Yixuan2068296/Remote-Lab_Buck-Converter/Buck Lab - Complete Material/Replace Components/SER0046 - 270 degree Rotation Micro Servo.jpg

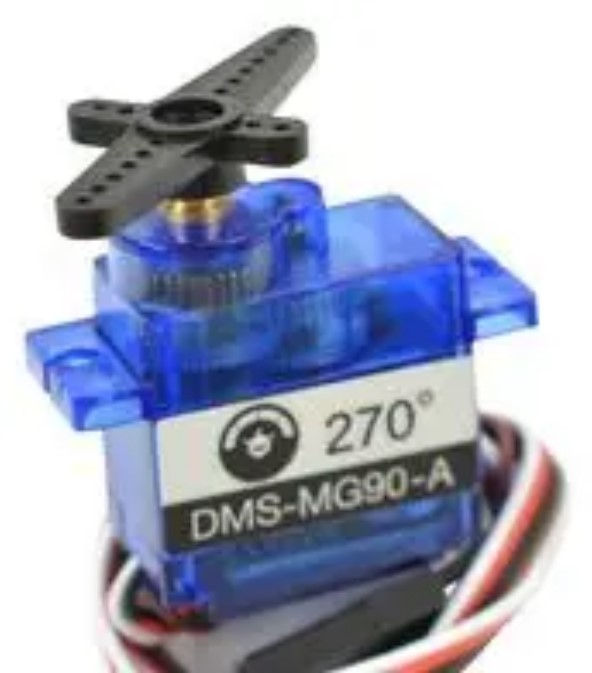
Buck Lab - Complete Material/Replace Components/SER0046 - 270 degree Rotation Micro Servo.jpg
