Yixuan2068296/Remote-Lab_Buck-Converter/README.md

# Remote-Lab_Buck-Converter
This is a logbook for my MSc project
