Yixuan2068296/Remote-Lab_Buck-Converter/Buck Lab - Complete Material/Replace Components/Components.xlsx

MCP4151-502E/P | 4 | Volatile Digital Potentiometer, 5 kohm, Single, SPI, Linear, ± 20%, 1.8 V | https://uk.farnell.com/microchip/mcp4151-502e-p/ic-dgtl-pot-sngl-5k-spi-8dip/dp/1840832?mckv=_dc|pcrid|565482043082|plid||kword||match||slid||product|1840832|pgrid|129965253803|ptaid|pla-1707592839797|&CMP=KNC-GUK-GEN-SHOPPING-SMART-AUTOMATION-HIGHROAS-Test860&gross_price=true
MCP4151-503E/P | 4 | Volatile Digital Potentiometer, 50 kohm, Single, Serial, SPI, Linear, ± 20%, 1.8 V | https://uk.farnell.com/microchip/mcp4151-503e-p/ic-dgtl-pot-sngl-50k-spi-8dip/dp/1840819?st=mcp415
NX3L4357GM,115 | 2 | Analogue Switch ICs ANLG SWT SP3T 3.3V | https://www.mouser.co.uk/ProductDetail/NXP-Semiconductors/NX3L4357GM115?qs=5C9Q4QJFsuNdi101Rt%2FxvQ%3D%3D
SER0046, | 2 | 270 degree Rotation Micro Servo | https://uk.farnell.com/dfrobot/ser0046/servo-motor-270deg-1-47n-m-6v/dp/3769942?mckv=_dc|pcrid||plid||kword||match||slid||product|3769942|pgrid||ptaid|&CMP=KNC-GUK-GEN-SHOPPING-PMAX-Low_ROAS-Test915&gross_price=true
sourcing map 50W 100R Ohm | 2 | Wirewound Ceramic Potentiometer Variable Rheostat Resistor with Knob | https://www.amazon.co.uk/dp/B07JLQXN8Z?s=industrial
