Yixuan2068296/Remote-Lab_Buck-Converter/Buck Lab - Complete Material/Replace Components/sourcing map 50W 100R Ohm.jpg

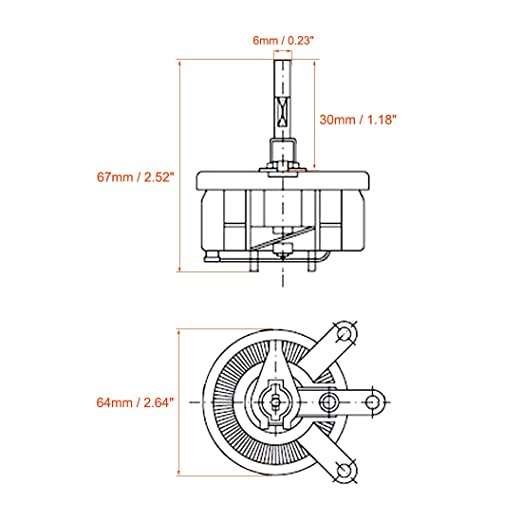
Buck Lab - Complete Material/Replace Components/sourcing map 50W 100R Ohm.jpg
