Yixuan2068296/Remote-Lab_Buck-Converter/Buck Lab - Complete Material/Logbook/Logbook_2022-06-24&25.pdf

Components Choice:
Arduino nano33 iot control:
4 Trimmer Resistors -> Digital Potentiometers
3 Switches -> Digital Switches

RV1 & RV2 (2.22KΩ) RV3 & RV4 (50KΩ)
- MCP413X（options: 5KΩ, 10KΩ, 50KΩ, 100KΩ）
- MAX5394 / MAX5395（options: 10KΩ, 50KΩ, 100KΩ） LC_MODE Switch
- NX3L4357 single pole triple throw.
SyncBuck Switch
- SN74LVC1G3157 single pole double throw. CapSelect Switch
– FDS8858CZ Dual N&P channel powertrench MOSFET Remain Problem: voltage drop at switch - MOSFET: Vds

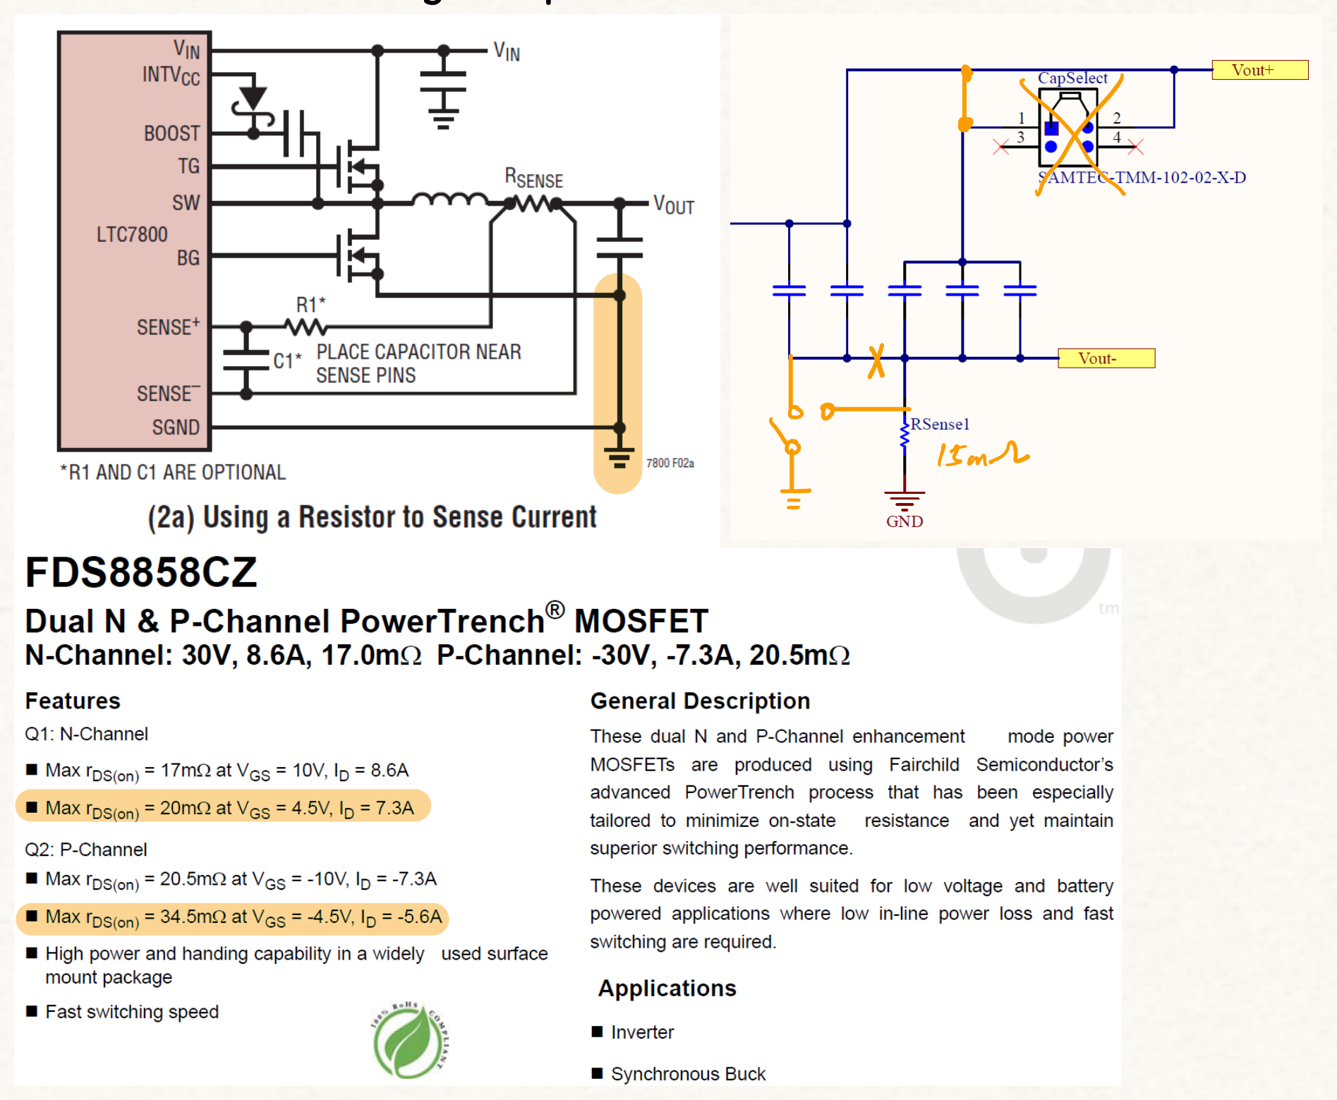
[picture p38: figure]

This voltage drop can be placed at Vout- and GND, which can replace original Rsense1 (0.015 Ohm).

Controllable Load Resistance
Approach 1: Digital potentiometer as load resistance.

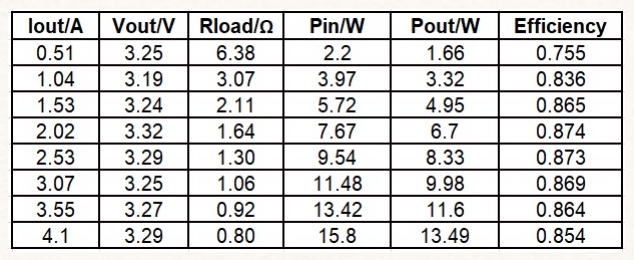
[picture p39: figure]

Resistance Requirement:
From Buck converter lab course, the load current should ramp up to 4A (5A is a max for load current). The graph shows load resistor variant range for 0-4A load current. As digital potentiometer minimum resistance is limited by wiper resistance
- around 60 Ohm, a few ohm resistance can not be achieved by digital potentiometer.
Power Handling Capability:
The load resistance consume high power 13.5W for 4A&3.3V output. Max output power is up to 30W. Digital potentiometer only has mW power rating. (Smallest digital potentiometer X9C102 - 1K Ohm)
Conclusion: Digital potentiometer cannot be used as a dummy load for this buck converter.

Approach 2: Rheostat as load resistance with a servo motor.
It is easy to find a high power low resistance shaft potentiometer (50W & 30 Ohm wire wound ceramic potentiometer). It is also easy to find a rotation servo motor (6V analog continuous rotation servo motor)
Arduino has a very traitor forward function to write to servo (rotate 0-360 degree)
Conclusion: This is the simplest and safest way to build a remote control resistance variable dummy load.

Approach 3: Switching a bank of fixed resistors.
Resistance Requirement & Power handling capability:
Power film resistor: MP9100 TO-247 Kool-Pak has following resistance values & 100W continuous power rating at 25 degree case temp with heat sink

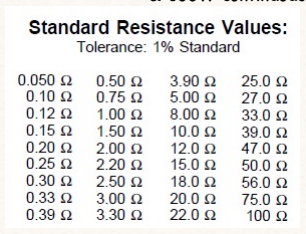
[picture p40: figure]

Switch design:
This lab course requires high resolution at small values, which makes the circuit for connecting fixed resistors complicated. The load resistance range is hard to make continuous and log scale.
The switch still has the problem of voltage drop, which will impact output current and voltage of the load.
Conclusion: A bank of fixed power resistor requires complex switch circuit design.

SyncBuck Switch
- SN74LVC1G3157 single pole double throw X
This switch has positive and negative voltage & current.
Need the same design as CapSelect switch
CapSelect Switch
– FDS8858CZ Dual N&P channel powertrench MOSFET X
This N&P channel MOSFET can support bidirectional current flow, but Arduino pin cannot provide the negative gate voltage of Vgs of P-type MOSFET.

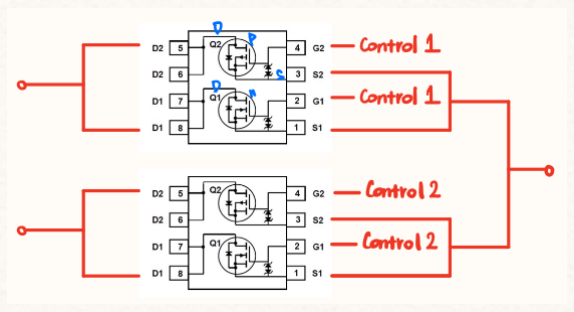
[picture p41: figure]

Dual N-type MOSFET: Drain and Source placed inversely to support bidirectional current flow.

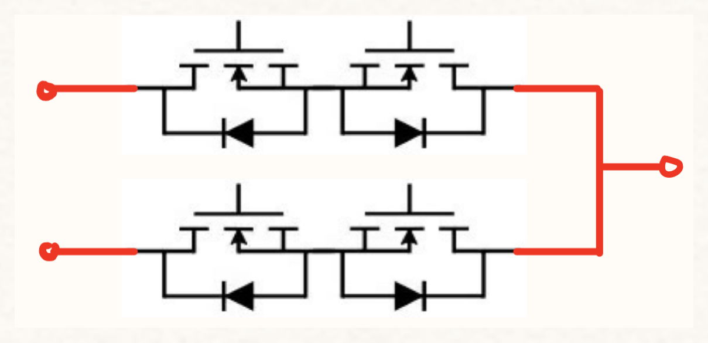
[picture p42: figure]
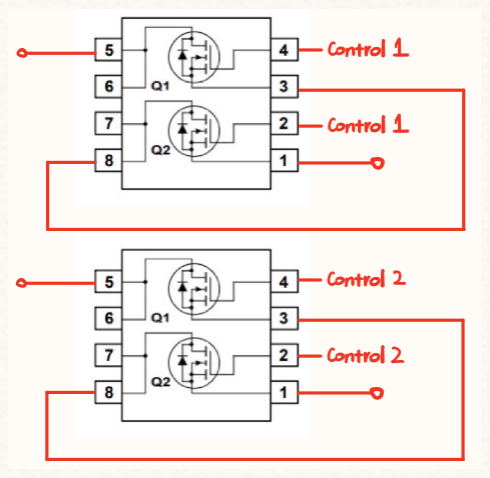
[picture p43: figure]

## LC_MODE Switch - NX3L4357

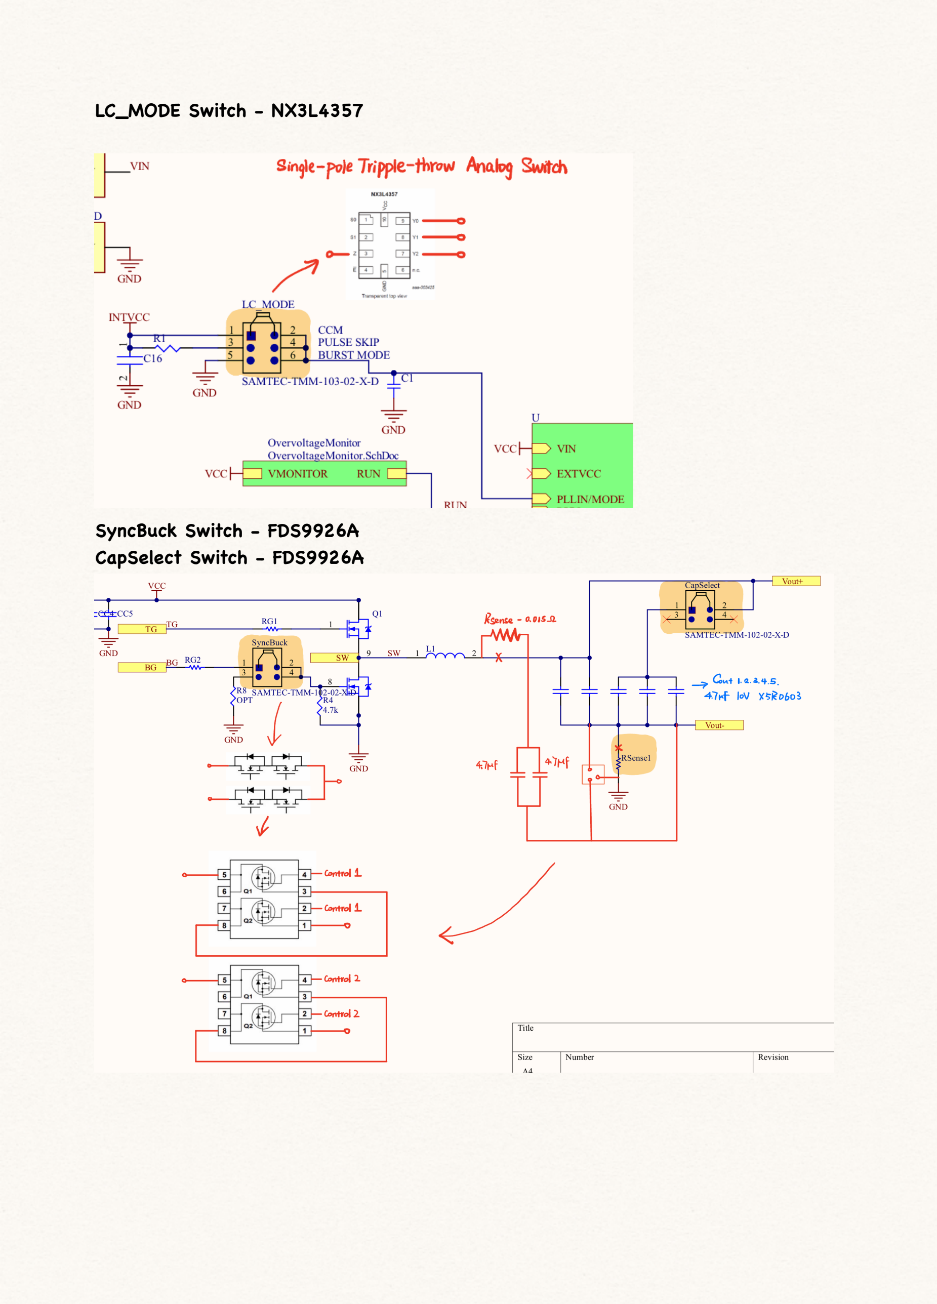
[picture p44: page 3]

## SyncBuck Switch - FDS9926A CapSelect Switch - FDS9926A

## RV1 & RV2 - MCP41X1

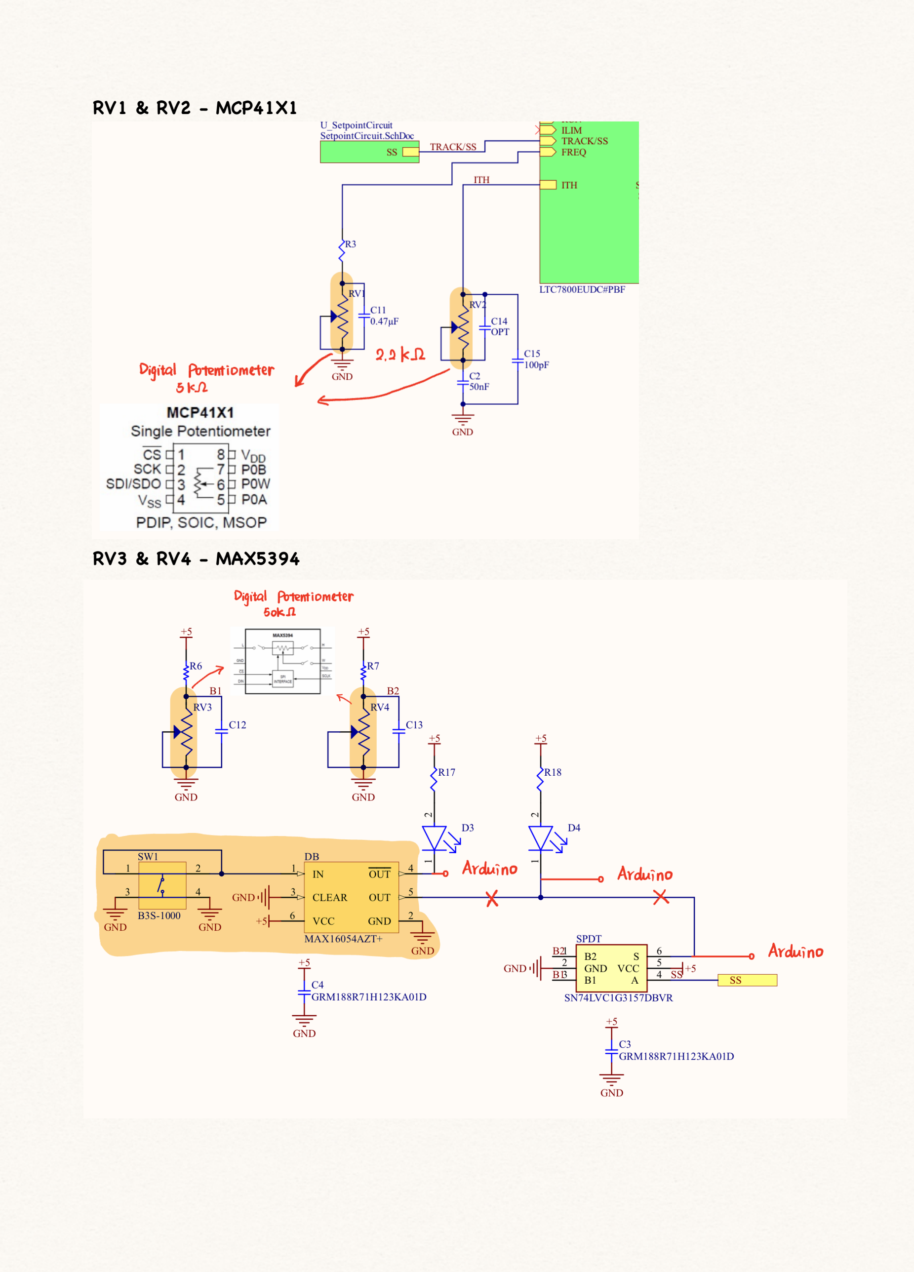
[picture p45: page 4]

## RV3 & RV4 - MAX5394
