Yixuan2068296/Remote-Lab_Buck-Converter/Buck Lab - Complete Material/Logbook/Logbook_2022-06-26.pdf

Controllable Load Resistance:
Pair of Servo motor (4.8V 270 degrees rotation servo) + Rotary potentiometer (50W 100 Ohm) Arduino IDE - PWM signal control motor to rotate and stop at specific angle.
(Careful: the 360 degrees continuous servo will spin and never stop
20ms period 50HZ: 1.5ms stop; 1ms counterclockwise full speed; 2ms clockwise full speed.) 20ms period 50HZ: 1.5ms stop at middle position; 0.5~2.5ms rotate in 270 degrees.

Arduino servo example code:
Use potentiometer to control servo motor angle position.

For this project, the servo motor mounted with a rotary potentiometer, the angle position is received by deserialization of a Jason message. This time, the rotation range is 270 degrees. The datasheet for the 270 degree motor: pulse width range 0.5~2.5ms and 5us resolution; 50Hz 20ms period.
But entire range of servo rotate angle is 180 steps, which will lose rotate resolution.
Better to use myservo.attach(3, 500, 2500); //states the min and max setting are 500us and 2500us mservo.writeMicroseconds(500); //sets the servo position at 0 degree Minimum increment 5us
