Yixuan2068296/Remote-Lab_Buck-Converter/Buck Lab - Complete Material/Logbook/Logbook_2022-08-10.pdf

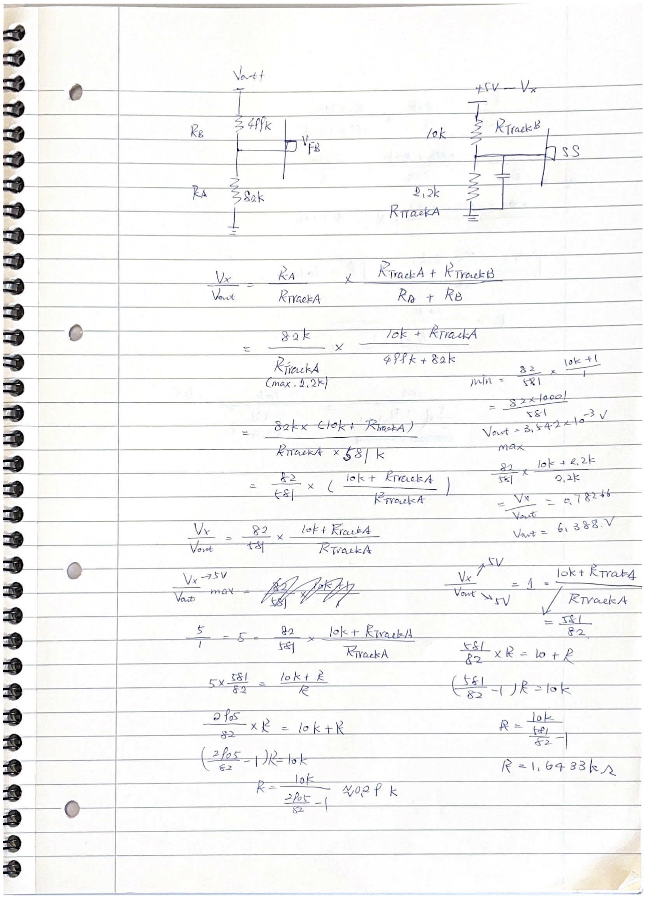
[picture p48: page 1]
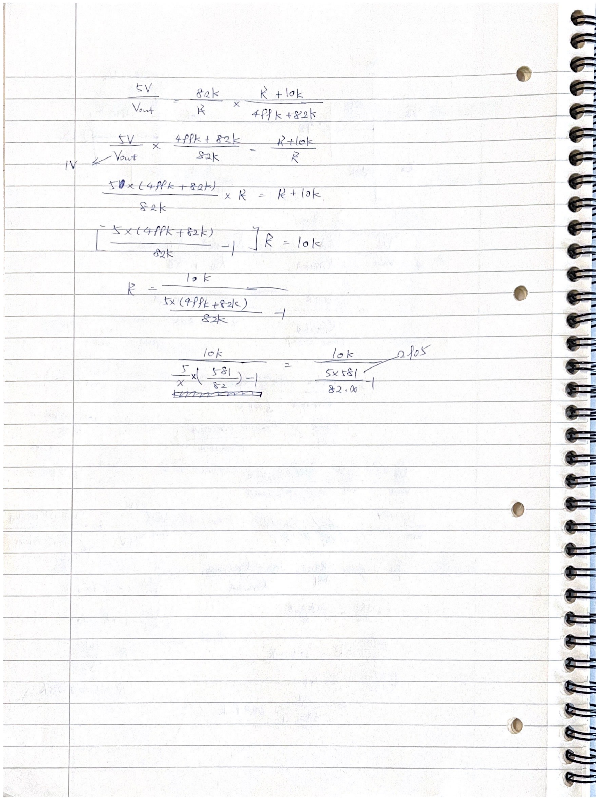
[picture p49: page 2]
