Yixuan2068296/Remote-Lab_Buck-Converter/Buck Lab - Complete Material/Logbook/Logbook_2022-07-21.pdf

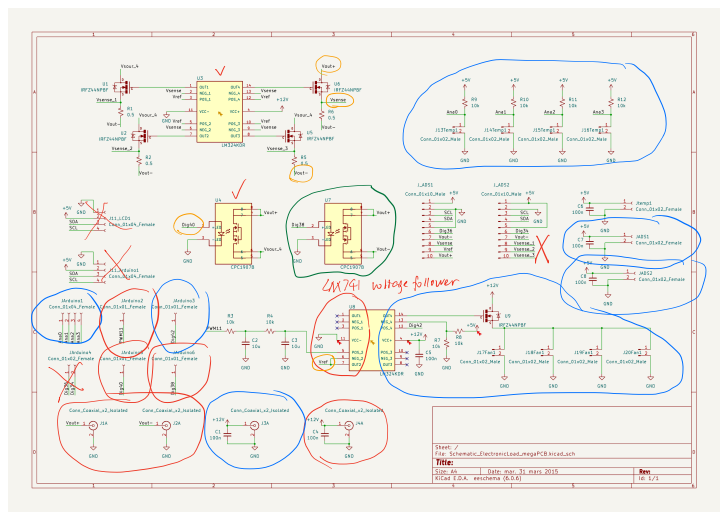
[picture p50: page 1]

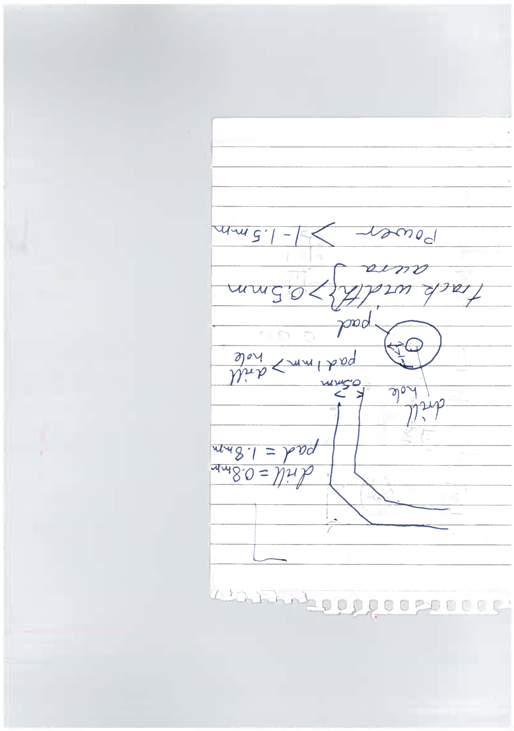
[picture p51: page 2]

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

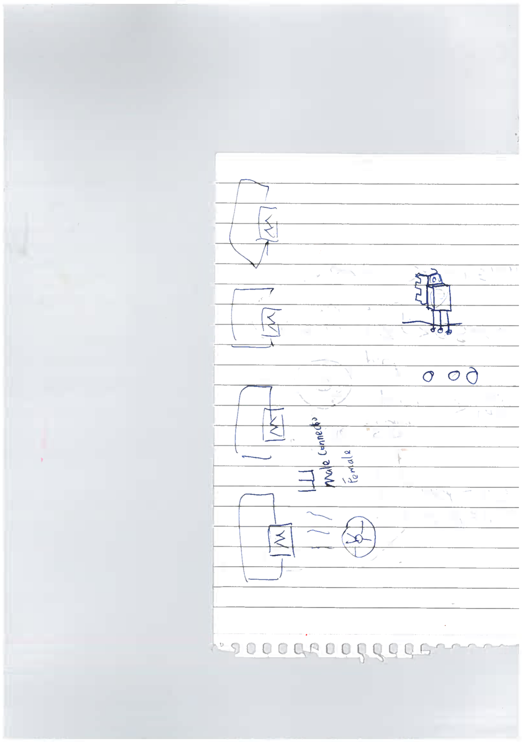
[picture p52: page 3]
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
