Yixuan2068296/Remote-Lab_Buck-Converter/Buck Lab - Complete Material/Logbook/SchematicAndBoardFiles Modification .pdf

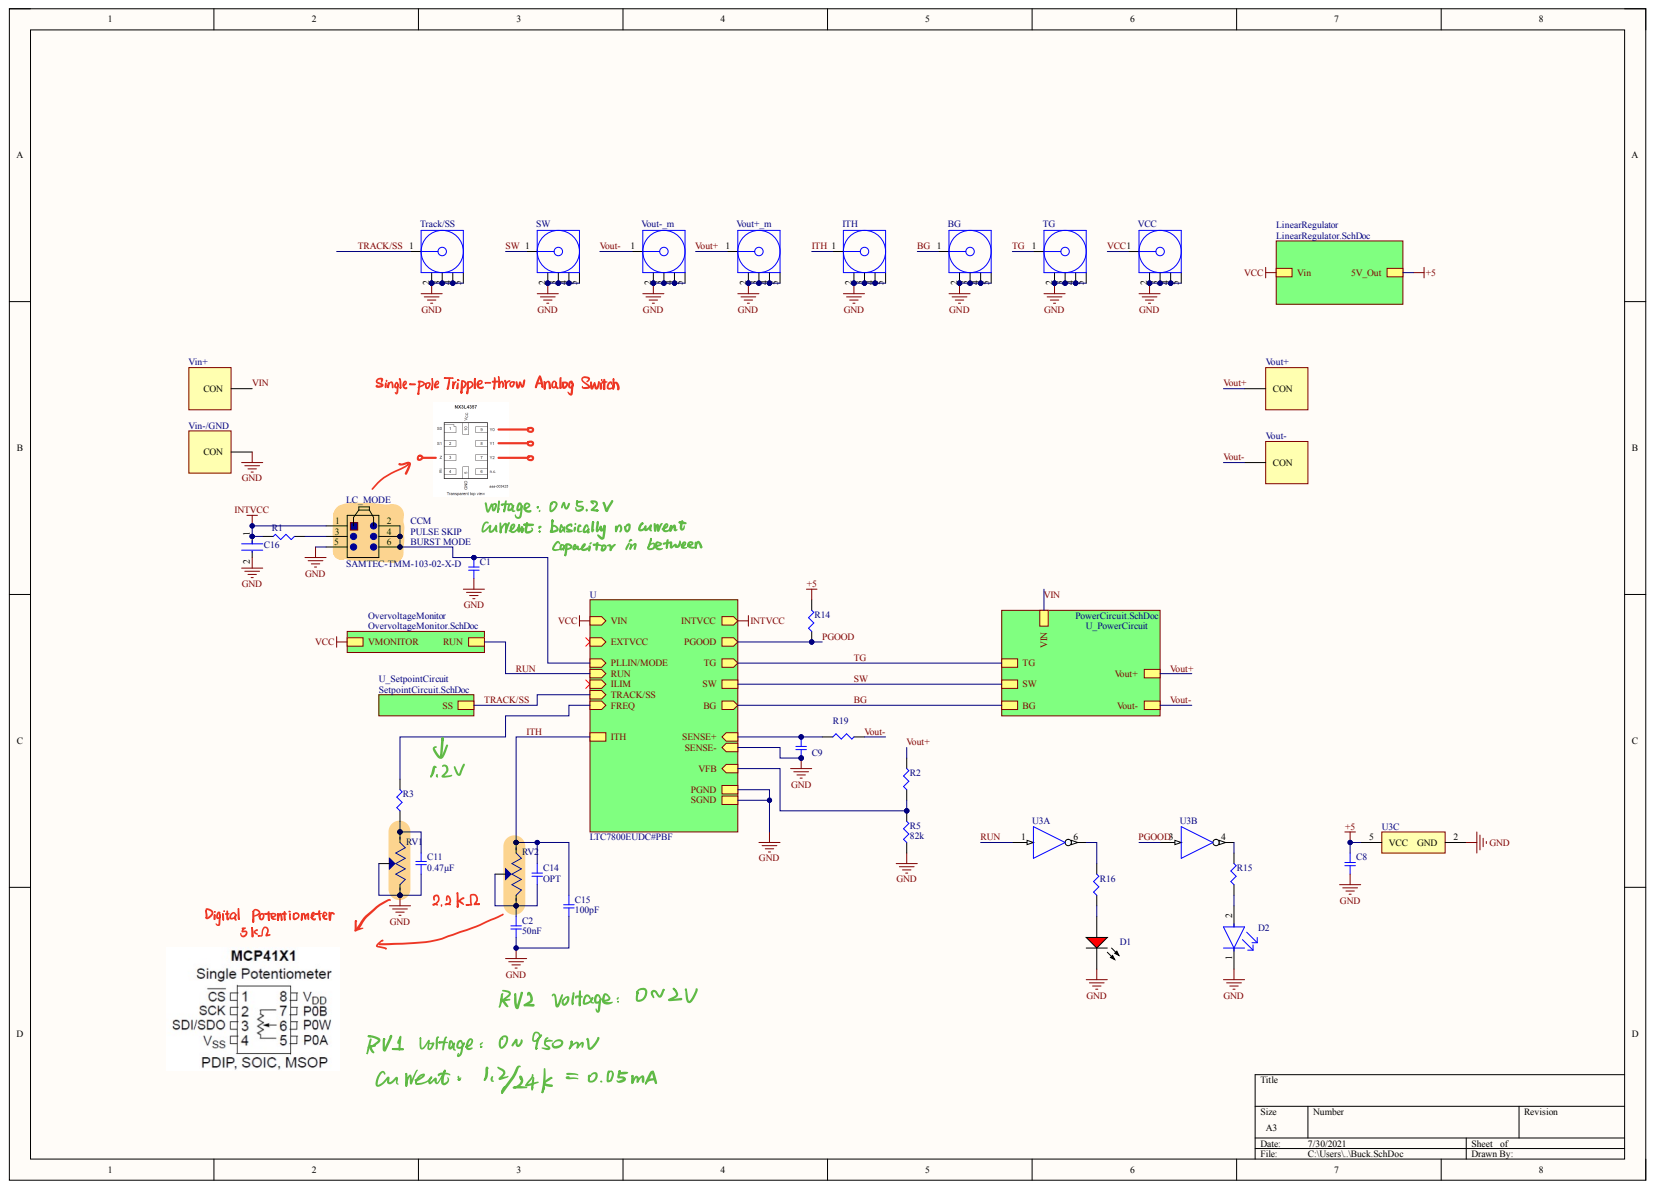
[picture p53: page 1]

witageia5 zvanen.basicagnouwenccapae.no

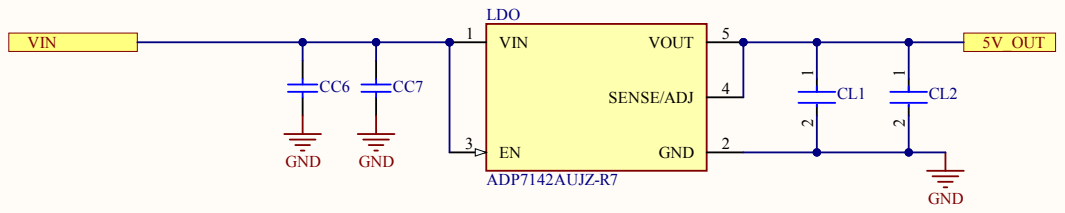
[picture p54: page 2]
Title; Size; Number; Revision; File:; C:\Users\..\LinearRegulator.SchDoc; Drawn By:; VIN; 5V_OUT; GND; VIN 1; VOUT; SENSE/ADJ; LDO; ADP7142AUJZ-R7

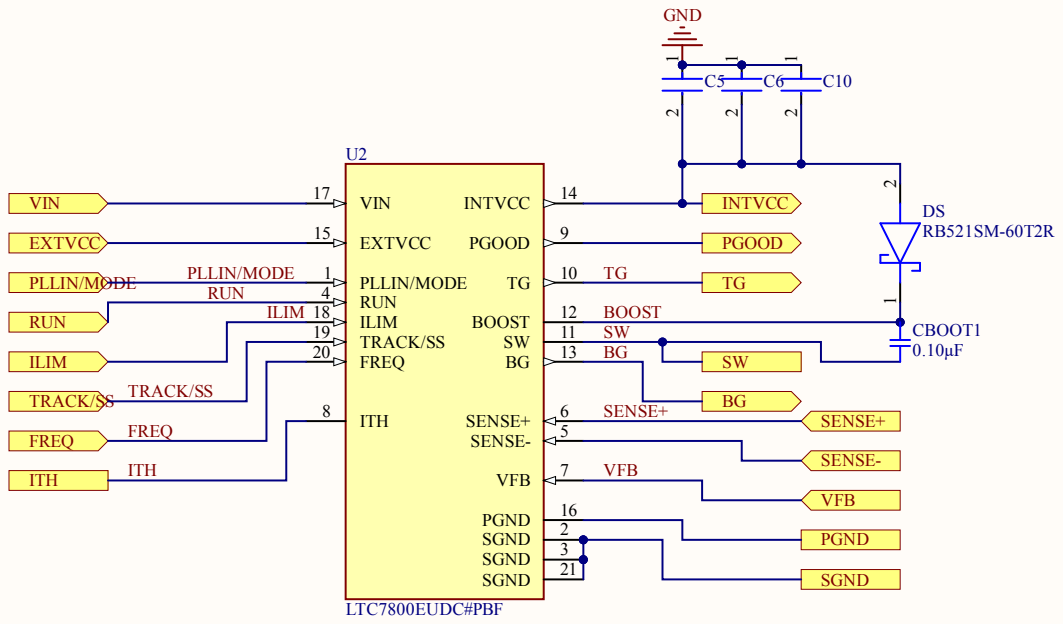
[picture p55: page 3]
Title; Size; Number; Revision; File:; C:\Users\..\LTC7800EUDC#PBF.SchDoc; Drawn By:; VIN; EXTVCC; PLLIN/MODE; RUN; ILIM; TRACK/SS; FREQ; ITH; INTVCC; PGOOD; SENSE+; SENSE-; VFB; PGND; SGND; VIN 17; EXTVCC 15; PLLIN/MODE 1 RUN 4 ILIM 18 TRACK/SS 19 FREQ 20; ITH 8; BOOST; LTC7800EUDC#PBF; GND; BOOST SW; CBOOT1 0.10µF

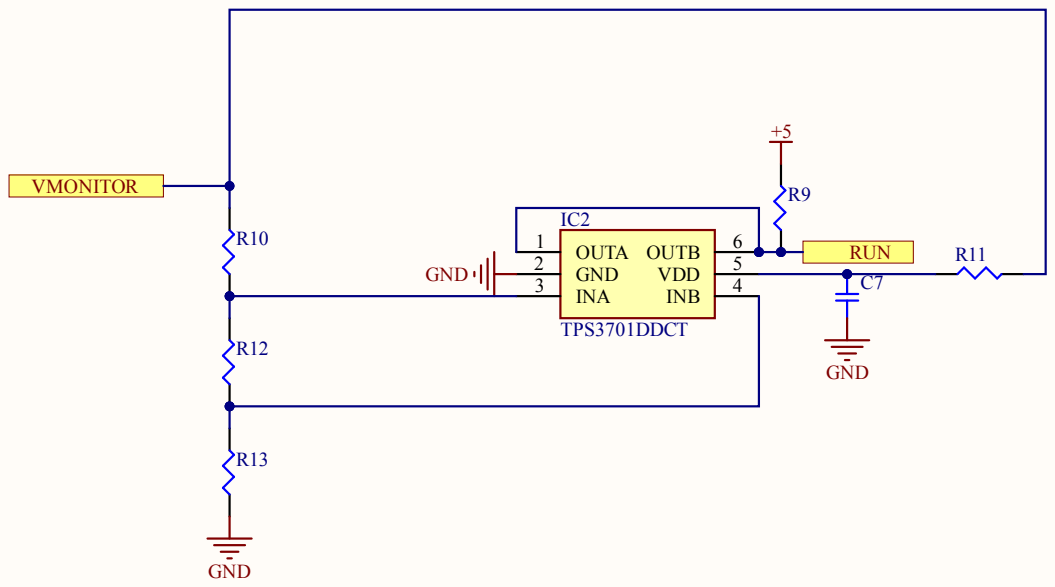
[picture p56: page 4]
Title; Size; Number; Revision; File:; C:\Users\..\OvervoltageMonitor.SchDoc; Drawn By:; OUTA; RUN 1; GND 2 INA 3; OUTB; VDD; INB; TPS3701DDCT; GND; VMONITOR

# Shortcircuit

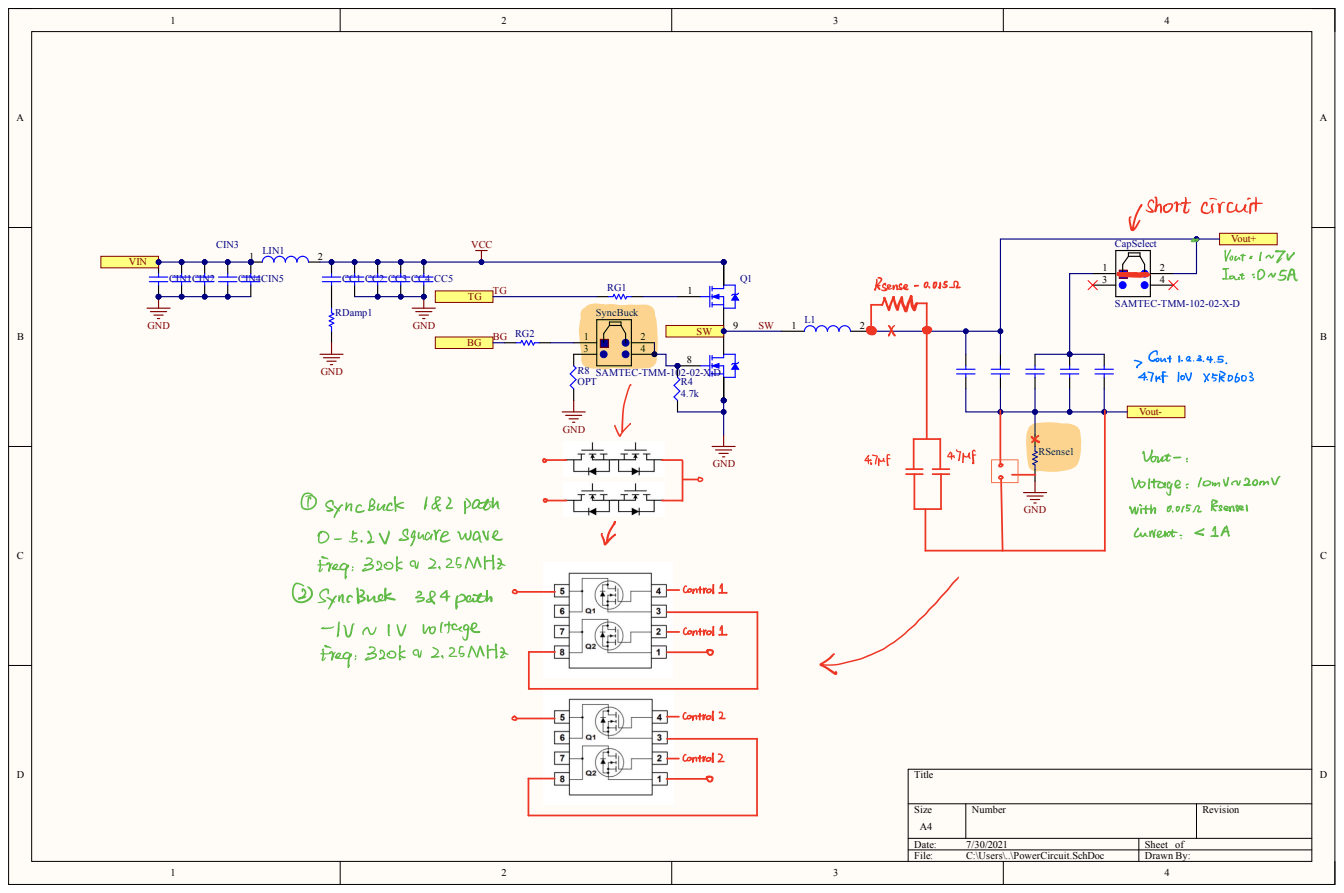
[picture p57: page 5]
Title; Size; Number; Revision; File:; C:\Users\..\PowerCircuit.SchDoc; Drawn By:; GND; 2 LIN1; RDamp1; CIN1CIN2; CIN3; CIN4CIN5; VCC; Vout+; VIN; RSense1; Vout-; SyncBuck; CapSelect; SAMTEC-TMM-102-02-X-D; 篮 䈄 iii ⼼; out23.4.5 4不⼲ 5知3; t.in syncBuck 12path; with anRena; awancut; treqi320ko225MHz; iiid-; control2

R8 SAMTEC-TMM-102-02-X-D OPT

ivuoitag N etreq.su 225MHz

## Digitalpotentiometer

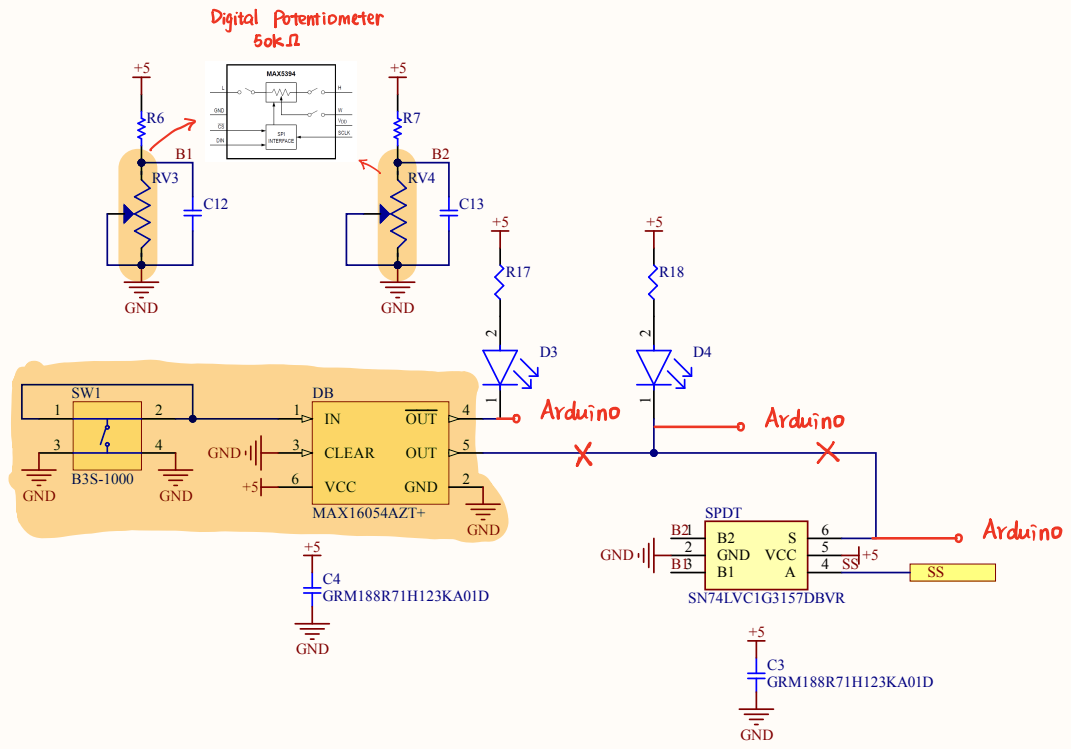
[picture p58: page 6]

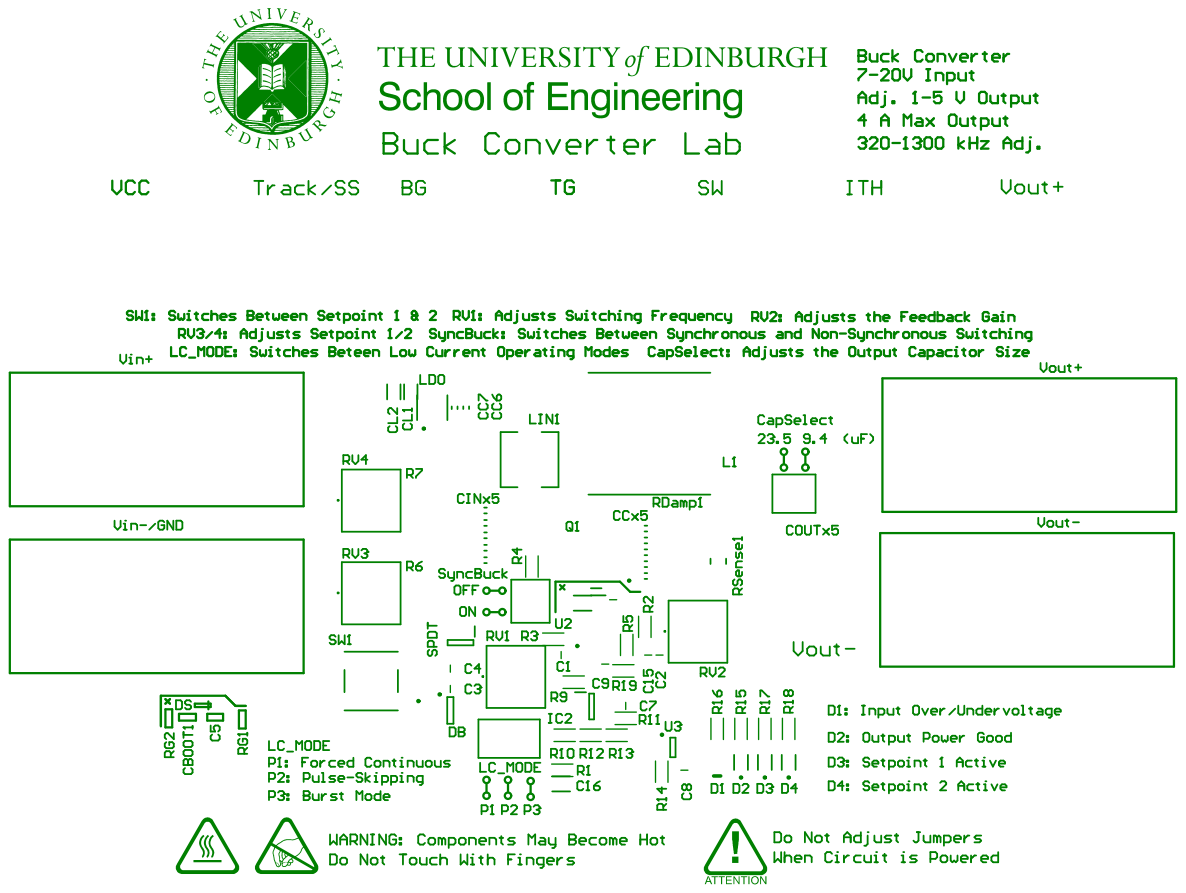
[picture p59: page 7]

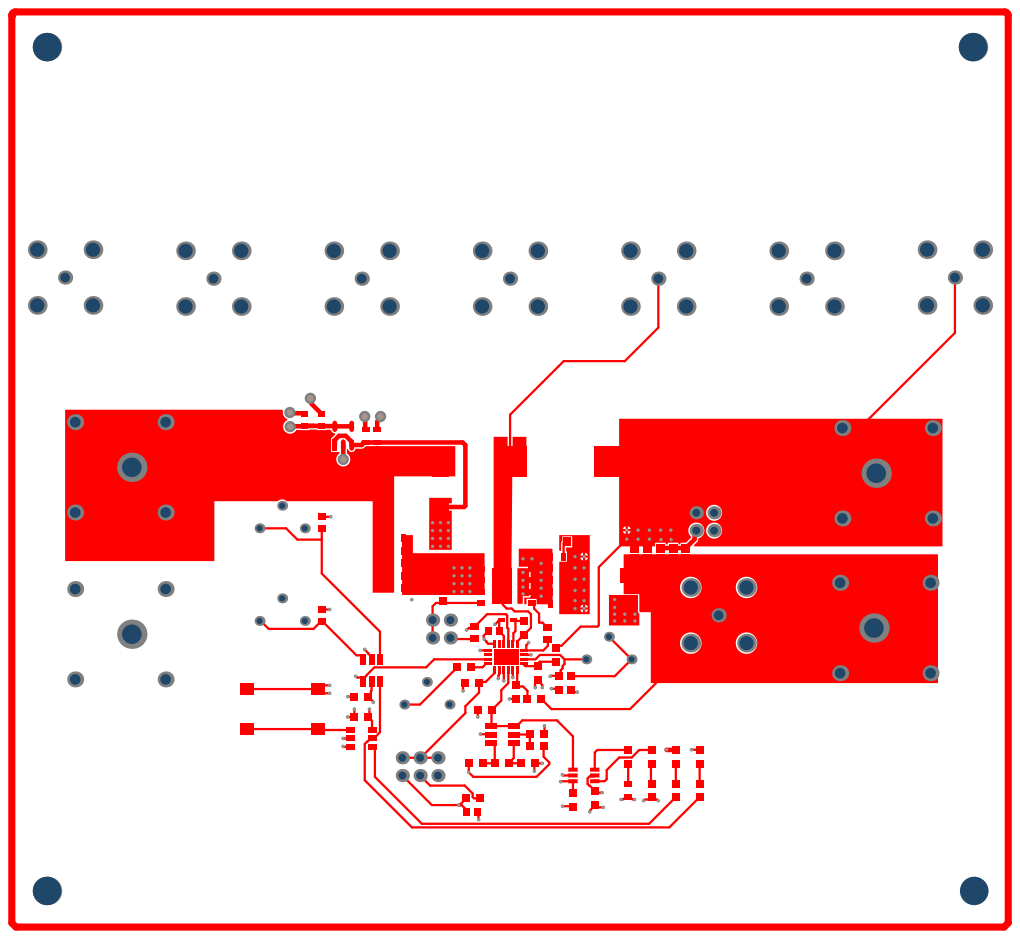
[picture p60: page 8]

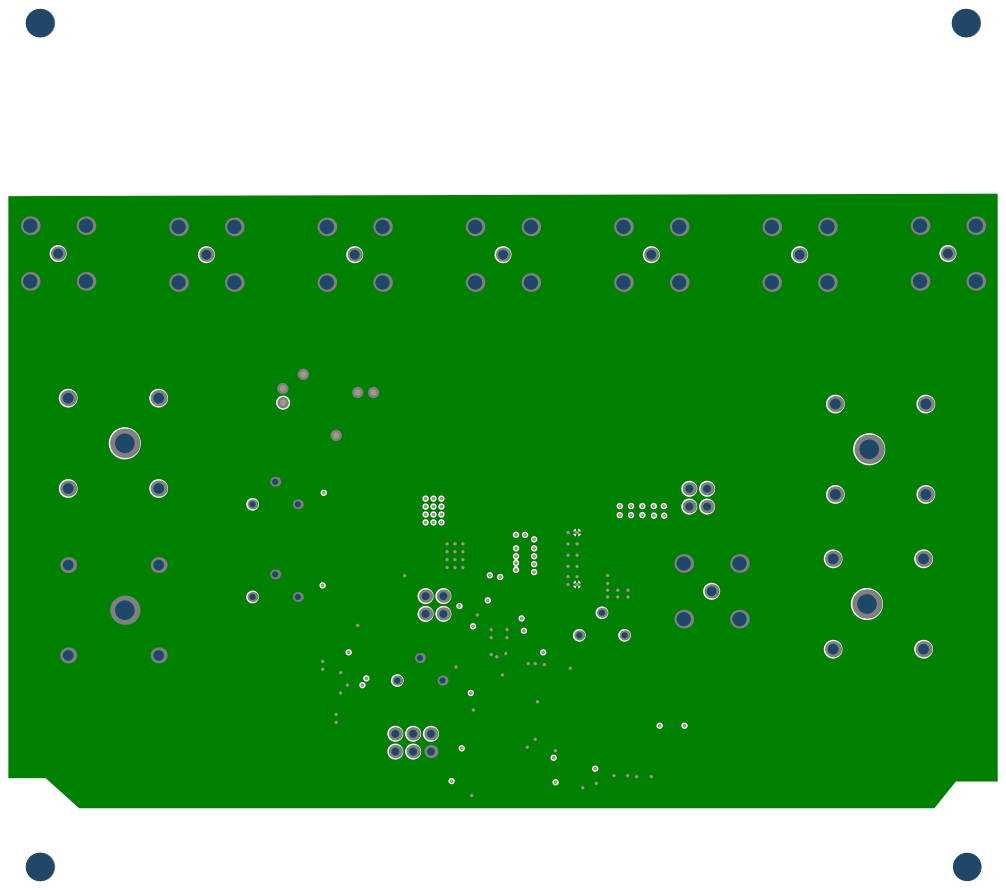
[picture p61: page 9]

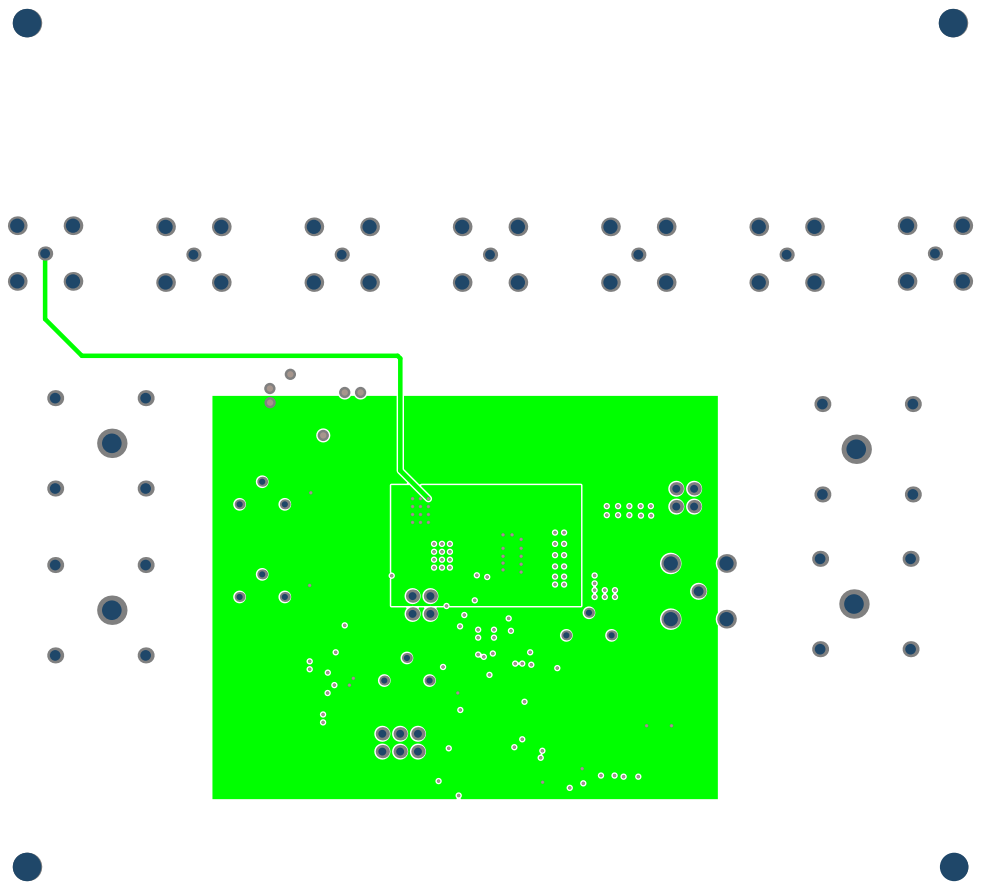
[picture p62: page 10]

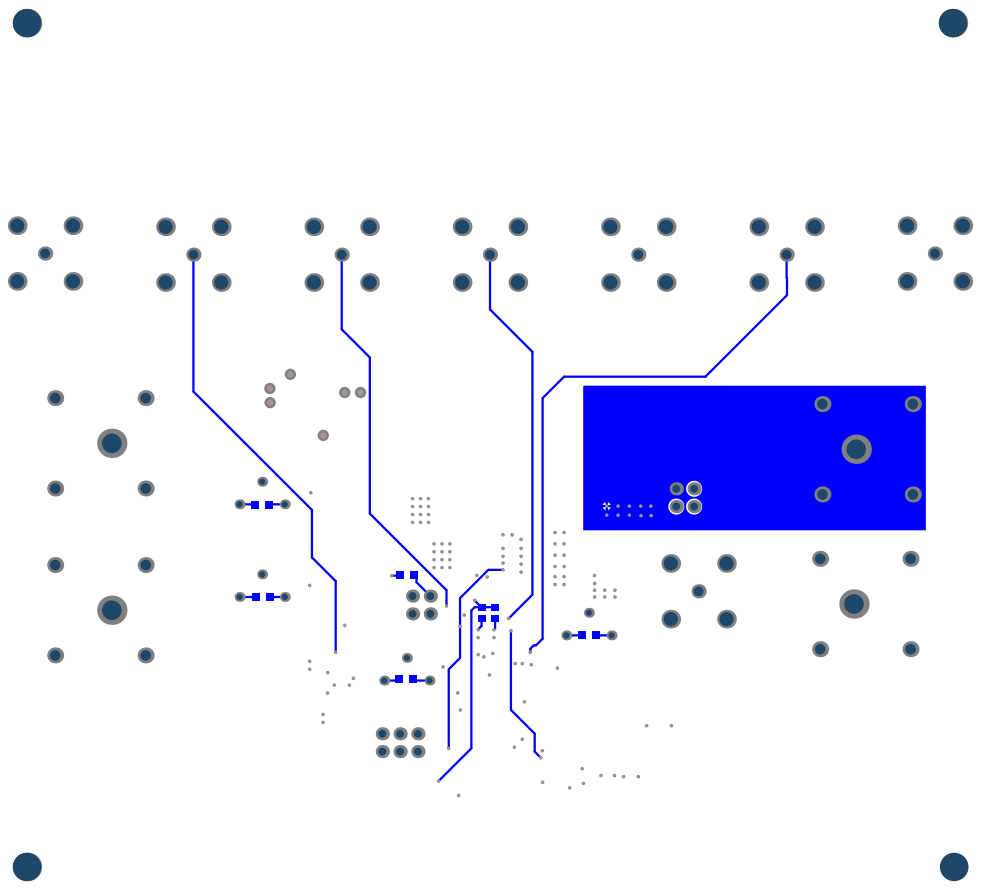
[picture p63: page 11]

# Board Stack Report
