Yixuan2068296/Remote-Lab_Buck-Converter/Buck Lab - Complete Material/PCB Schematic and Design Documents/SchematicAndBoardFiles.pdf

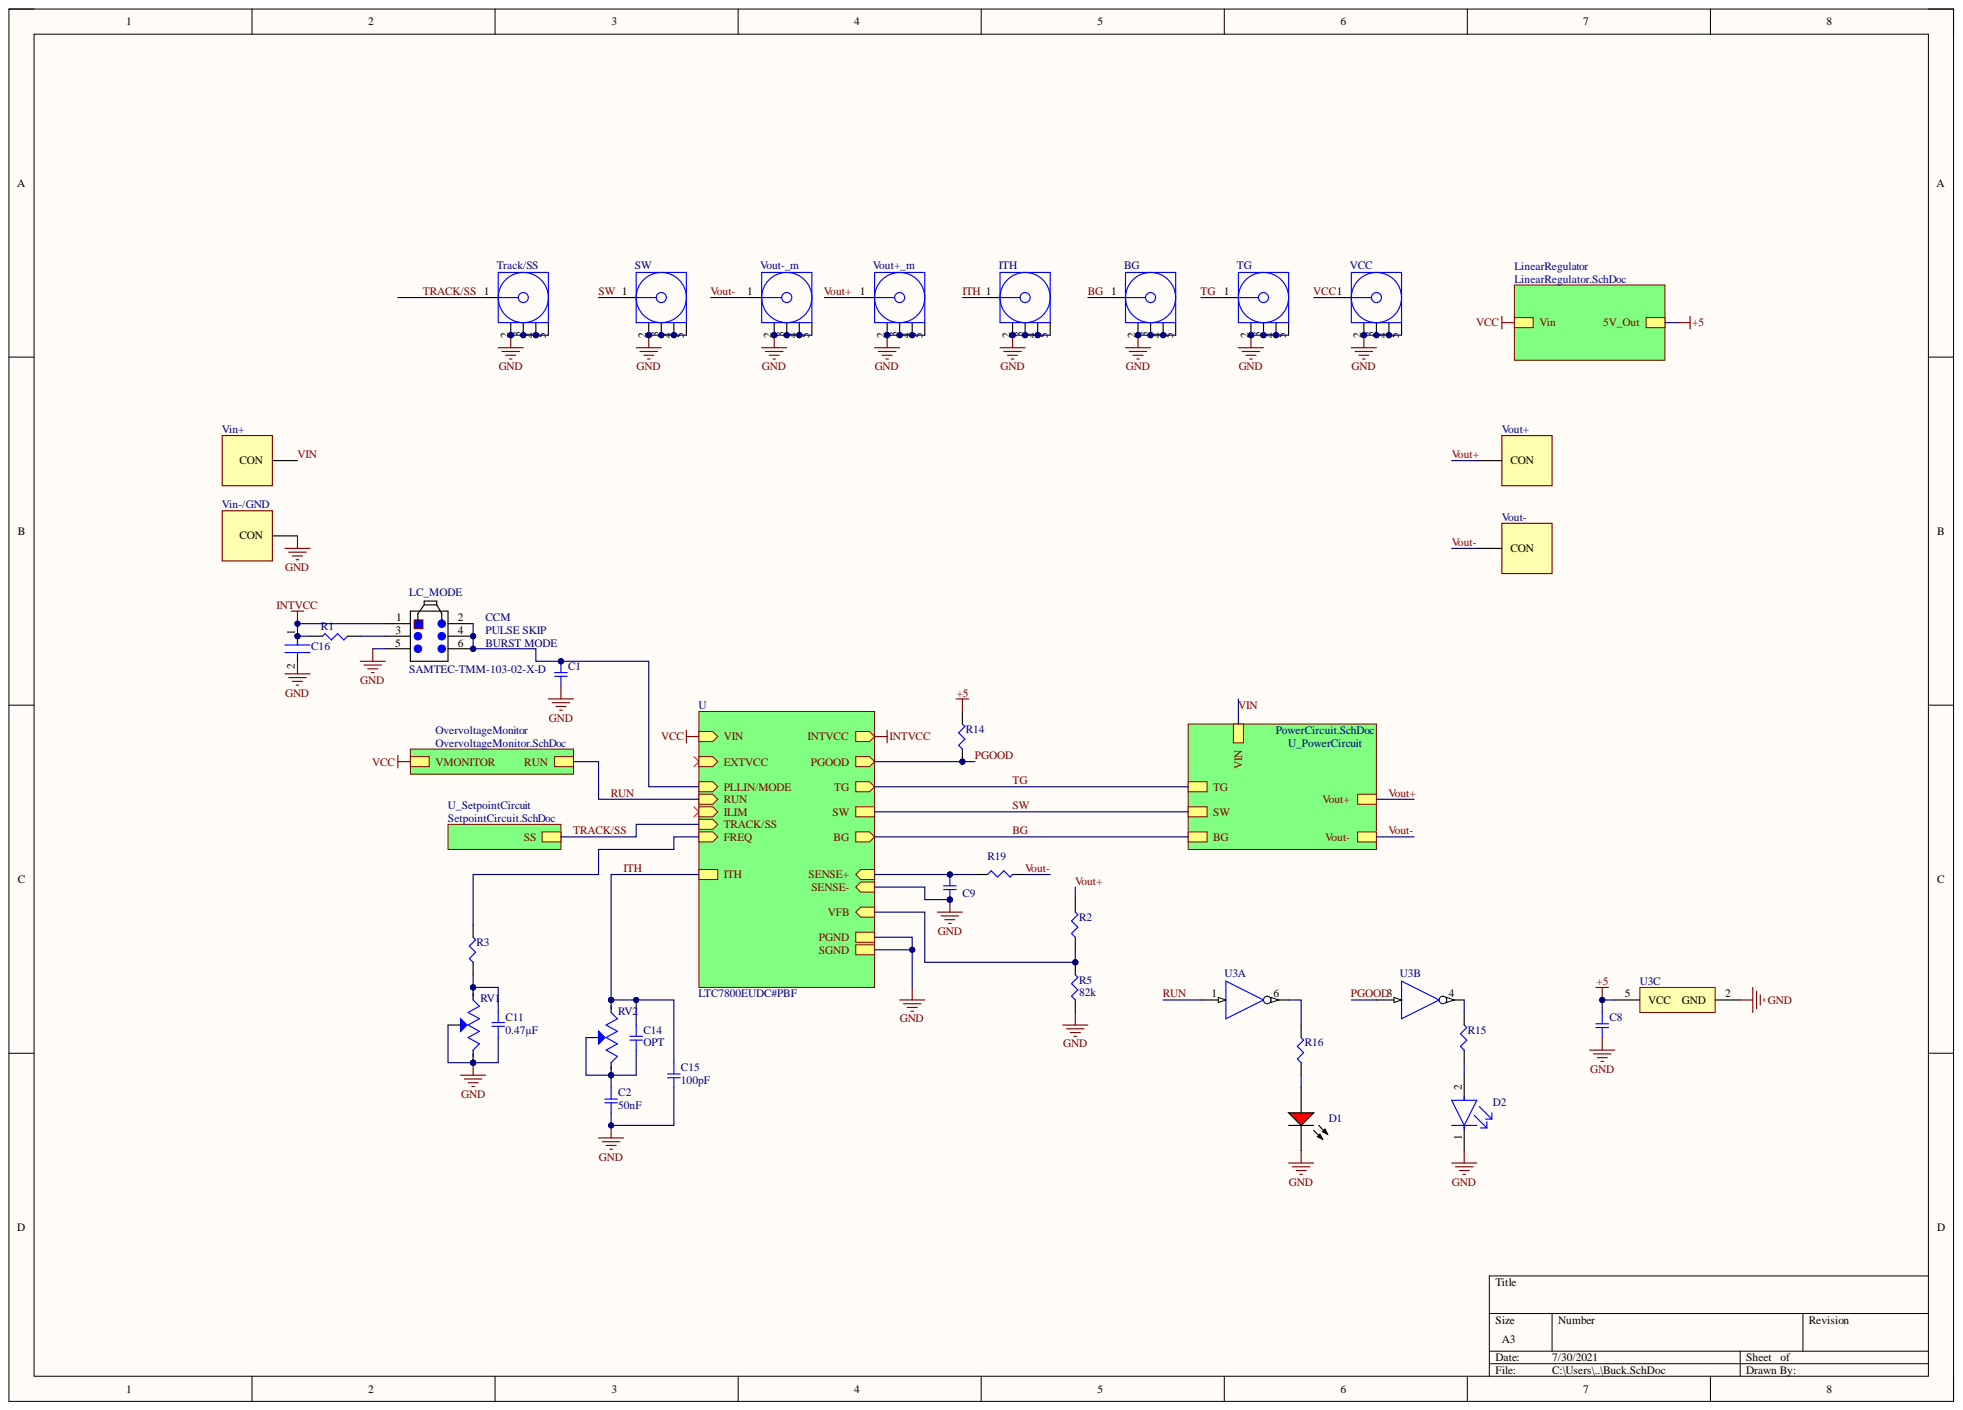
[picture p64: page 1]

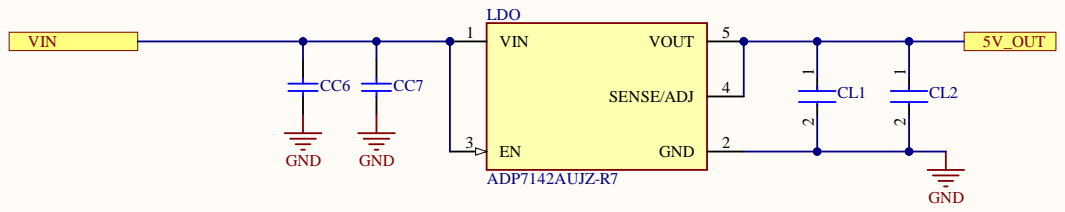
[picture p65: page 2]

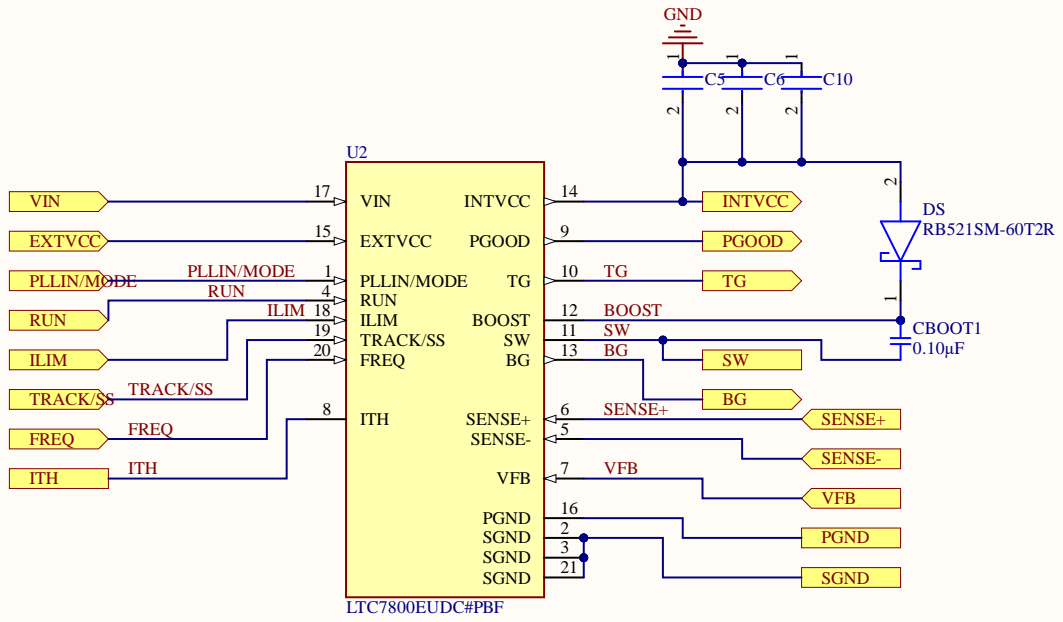
[picture p66: page 3]

FREQ 20 | BG

TRACK/SS | ITH 8

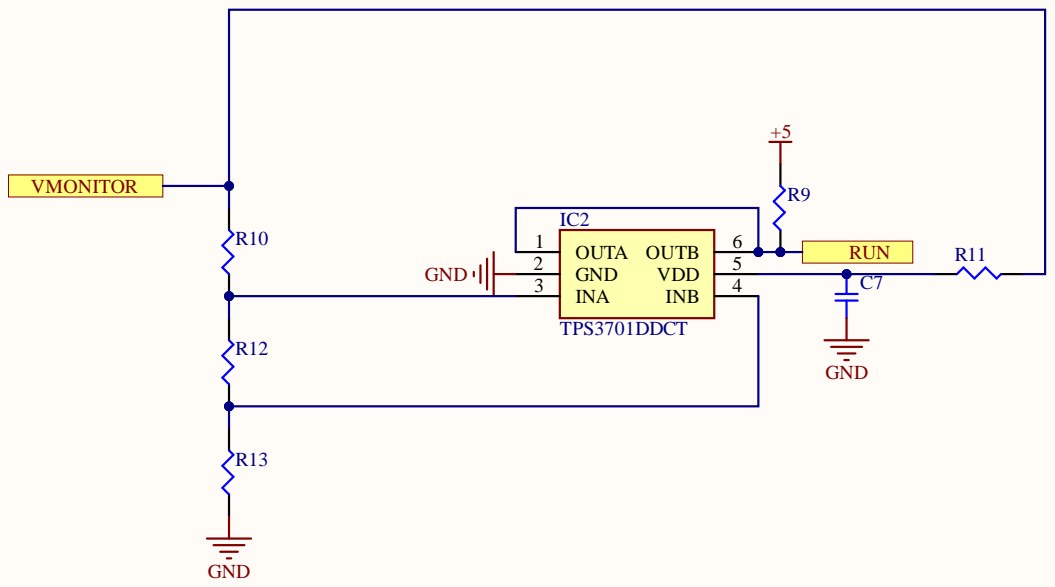
[picture p67: page 4]

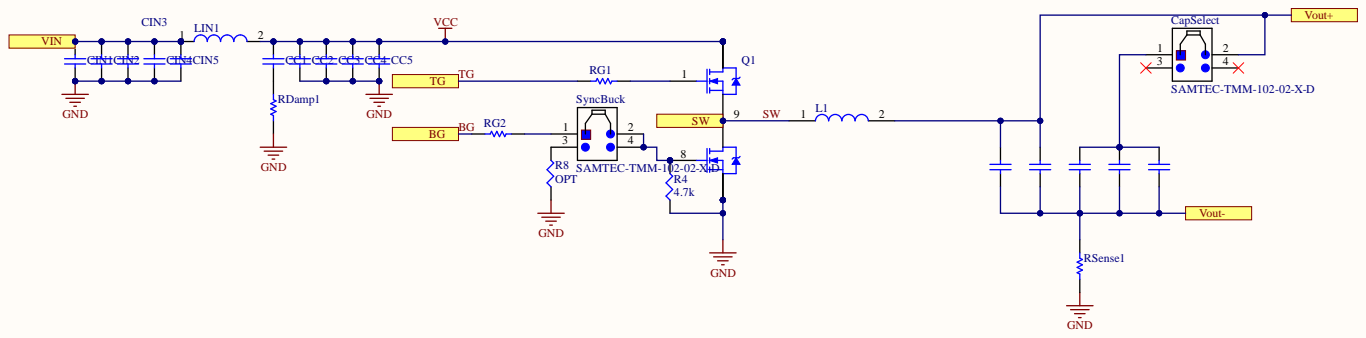
[picture p68: page 5]

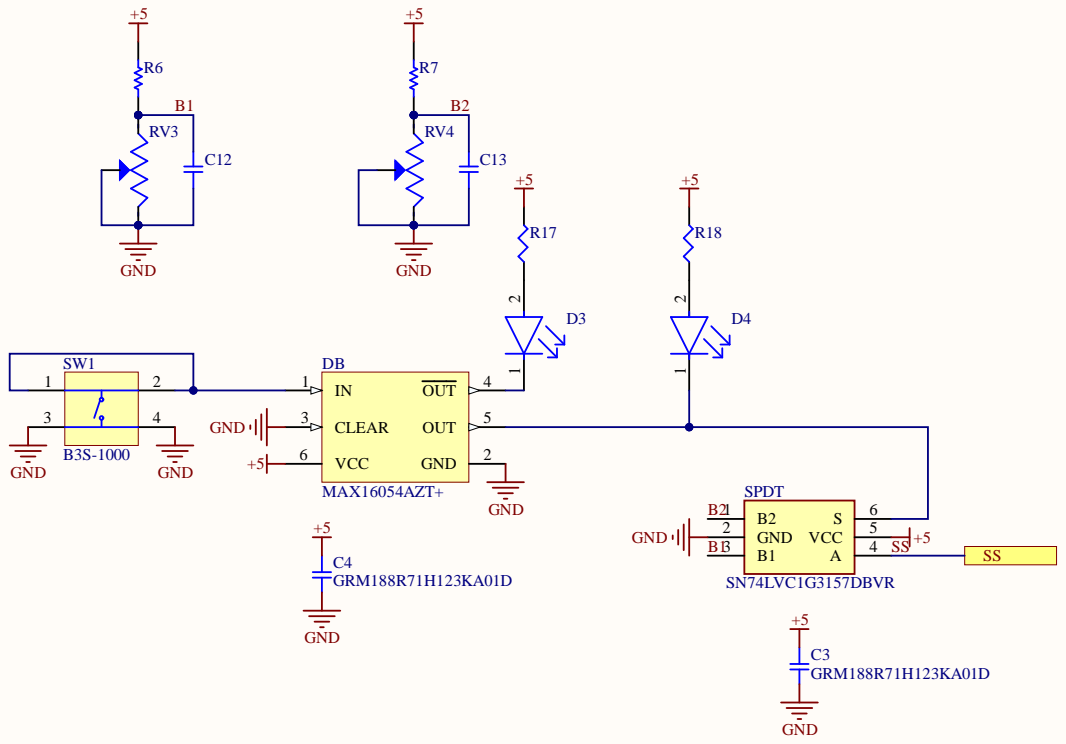
[picture p69: page 6]

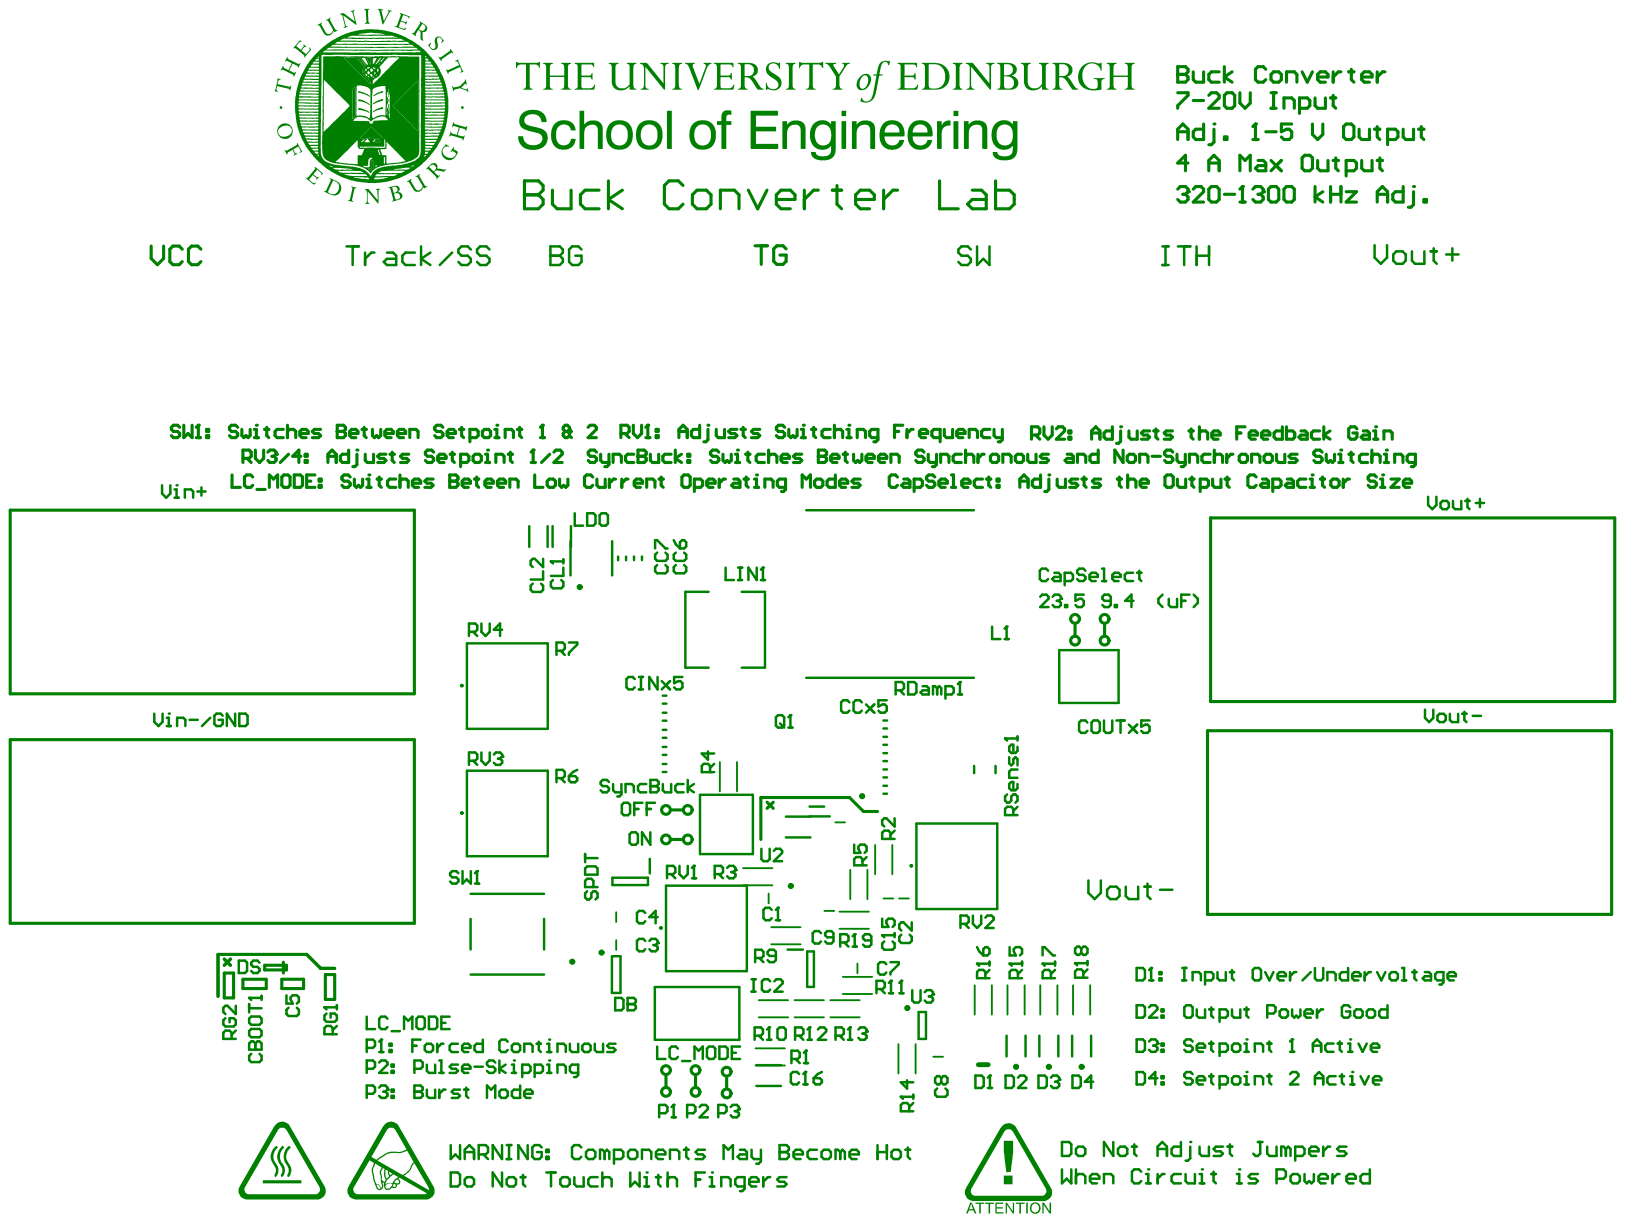
[picture p70: page 7]

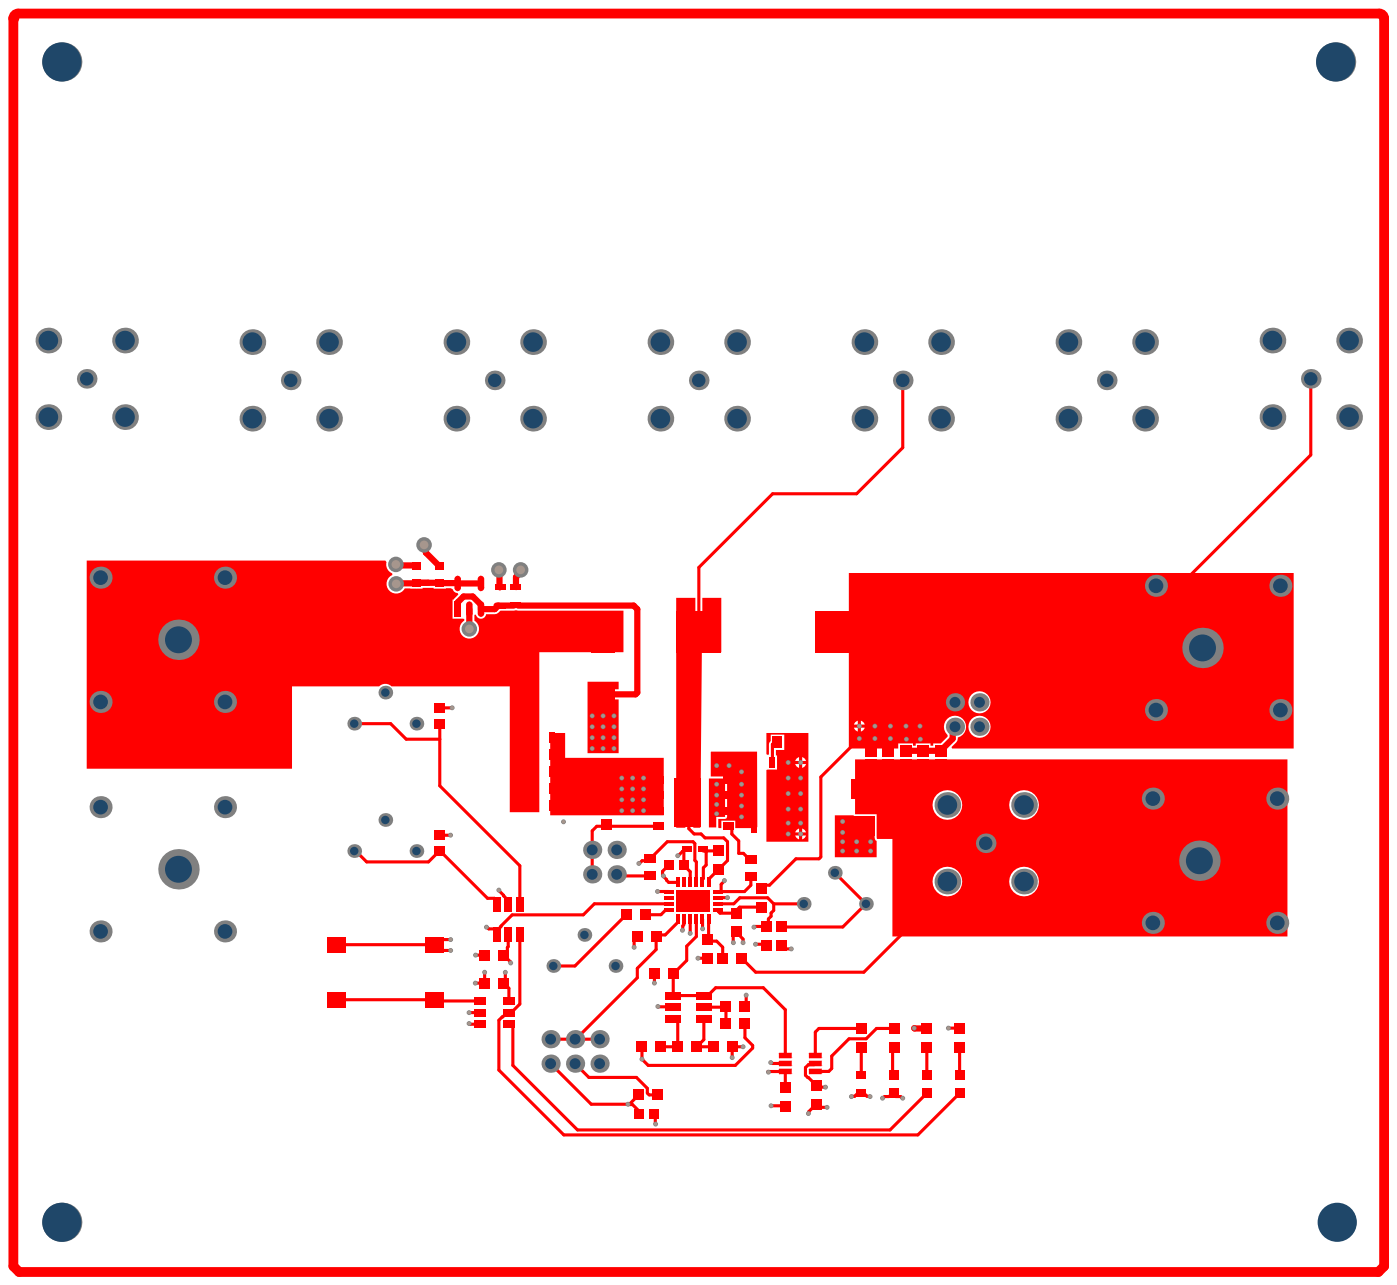
[picture p71: page 8]

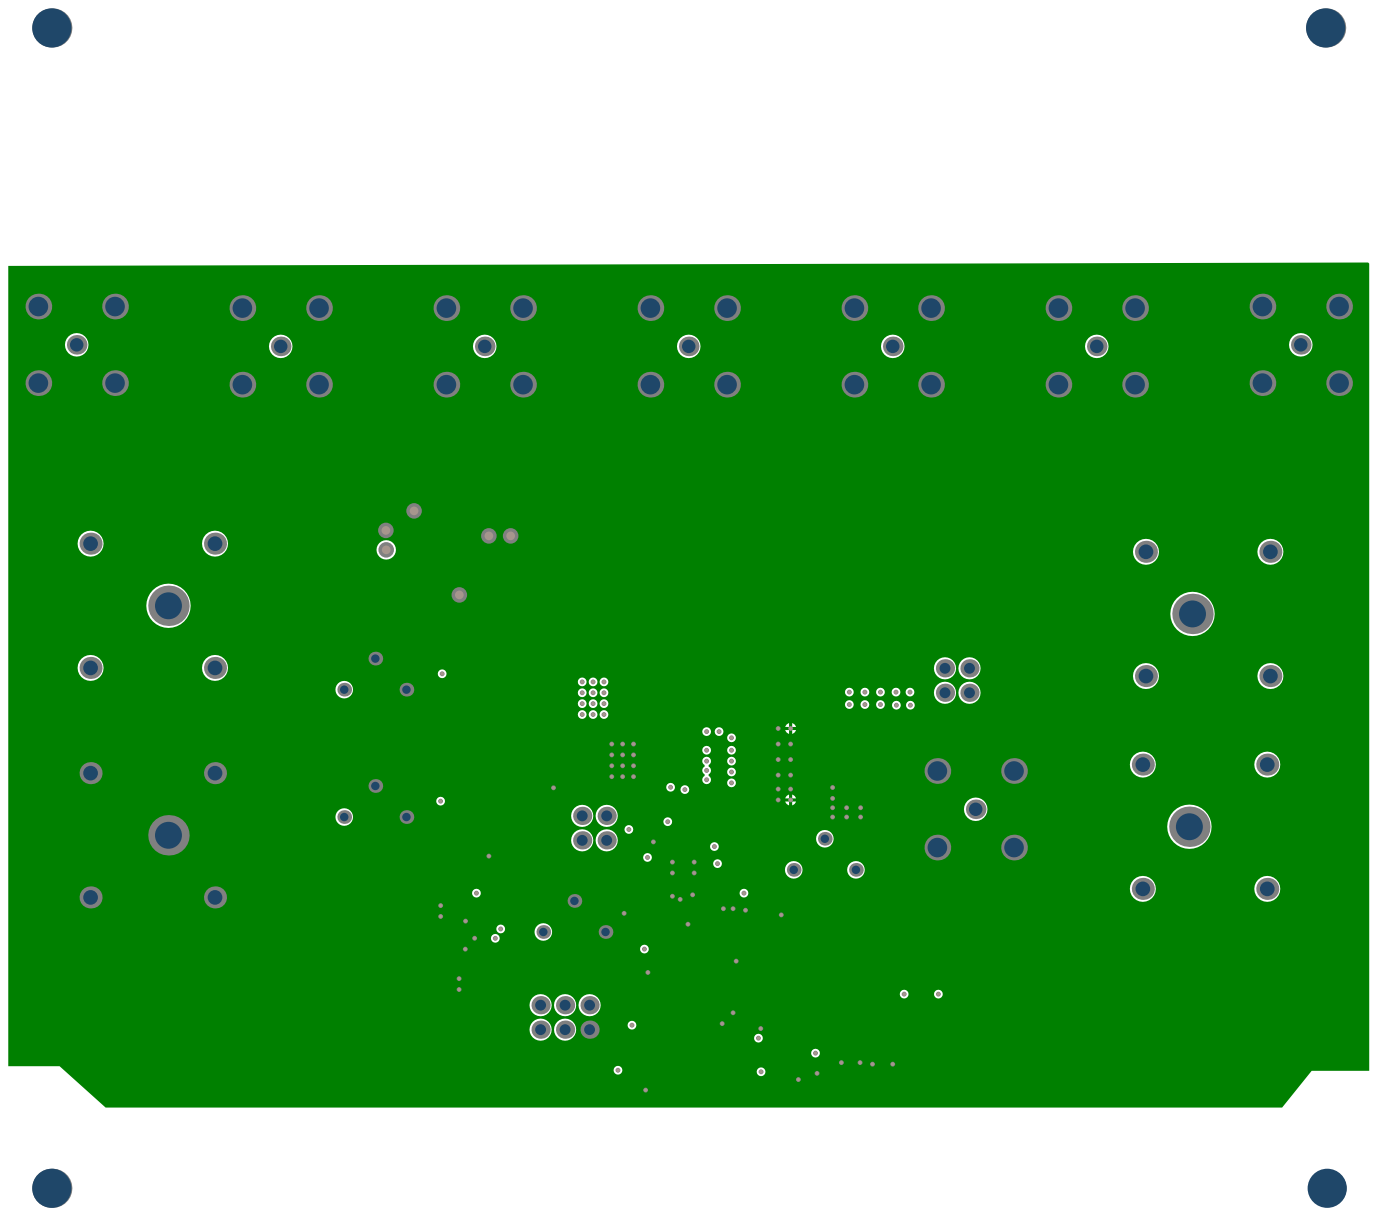
[picture p72: page 9]

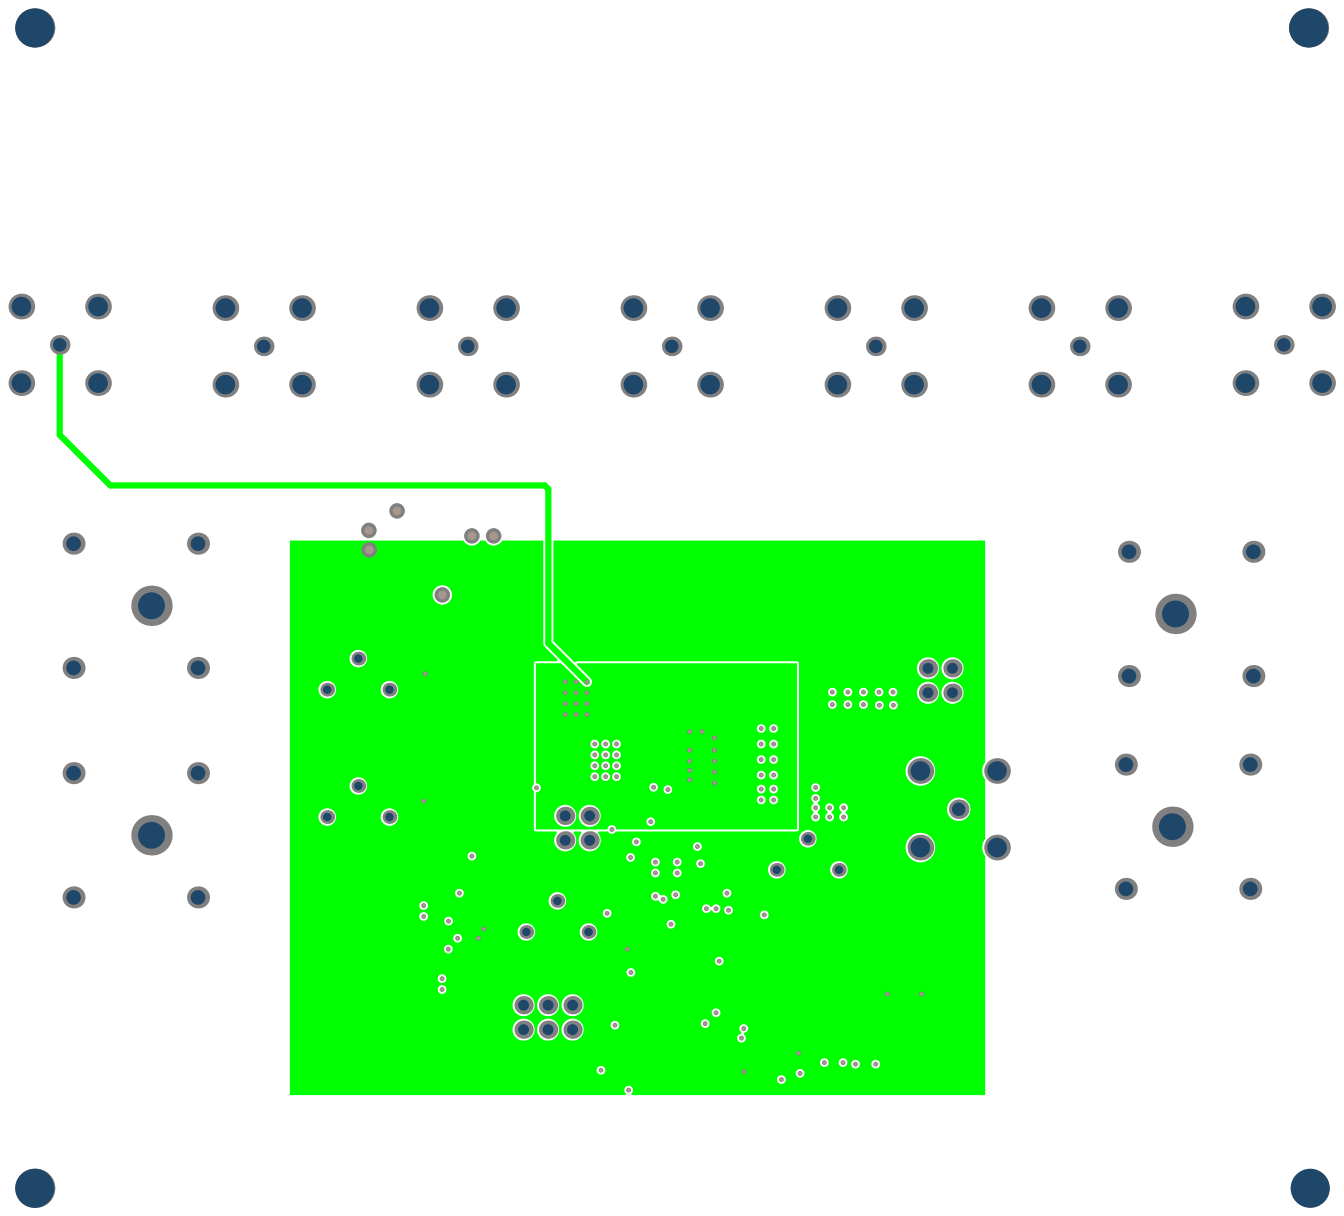
[picture p73: page 10]

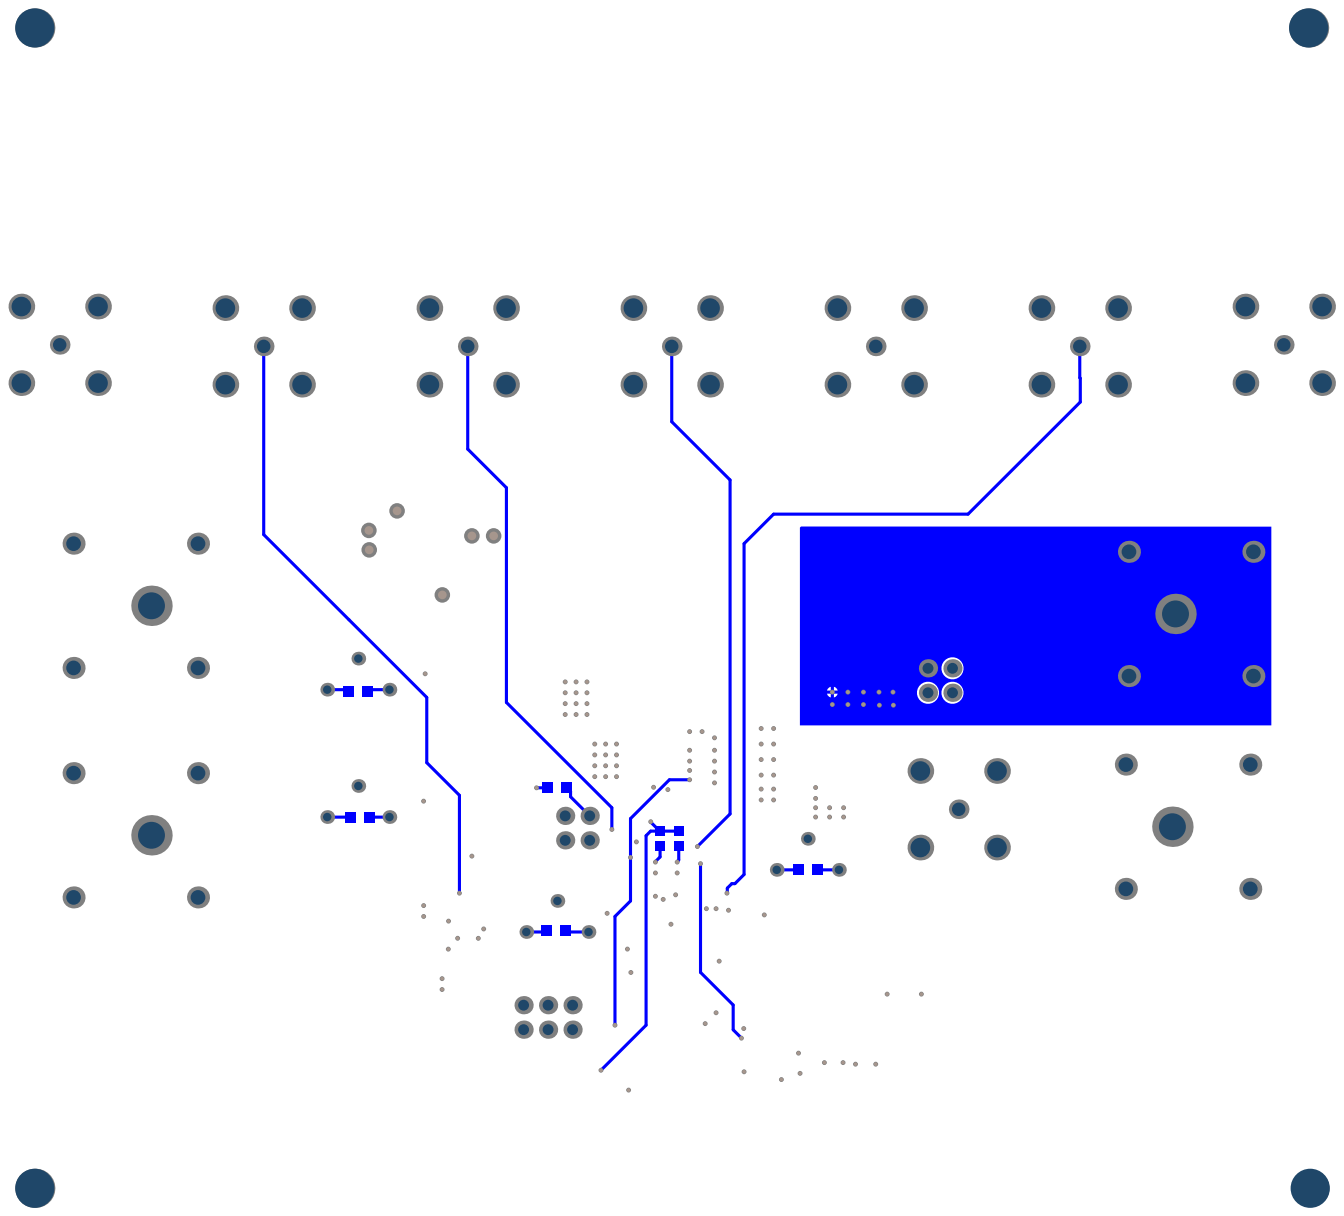
[picture p74: page 11]

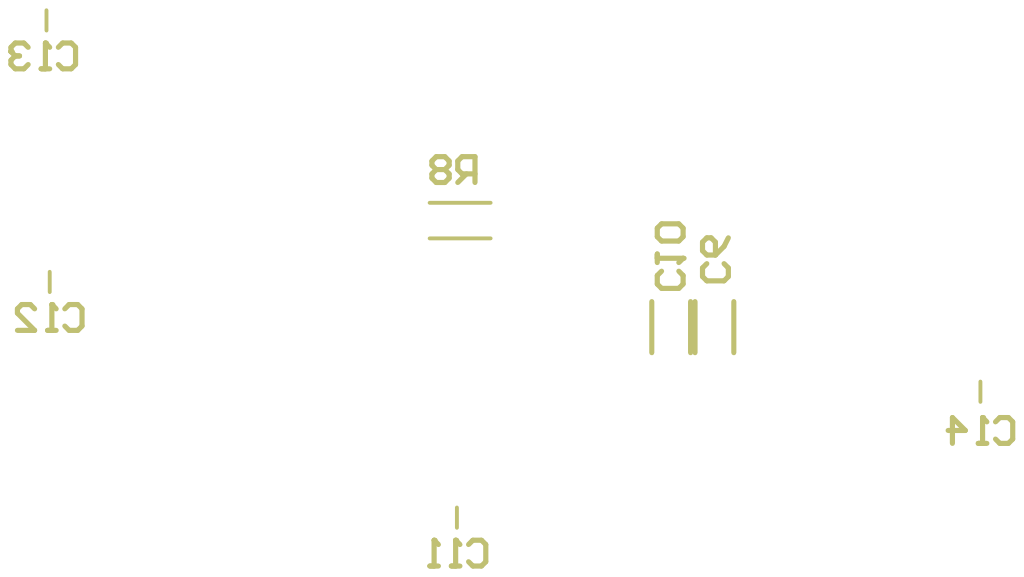
[picture p75: page 12]
