Yixuan2068296/Remote-Lab_Buck-Converter/(commit log)

2022-06-14 Add Buck Converter Lab Course Materials
    [ComponentList.xlsx]
2022-06-14 Add Buck converter PDF materials
2022-06-25 Datasheets for replace components
    [Components.xlsx]
